SantiagoArenas2/Arqui_proyecto3/asic/resultados/corridas.csv

corrida | terminada | CLOCK_PERIOD | FP_CORE_UTIL | die_area_um2 | core_area_um2 | area_celdas_um2 | utilizacion | celdas | flip_flops_sintesis | setup_ws | setup_ws_tt | setup_ws_ss_max | setup_tns | setup_tns_tt | setup_tns_ss_max | hold_ws | hold_ws_tt | hold_ws_ss_max | hold_tns | hold_tns_tt | hold_tns_ss_max | drc_magic | drc_klayout | drc_ruteo | lvs_errores | antena_redes | antena_pines | max_slew | max_cap | largo_ruteo_um | overflow_grt | cierra_timing | cierra_todo
ff | si | 100 | 40 | 2455570 | 2385420 | 1272700 | 0.533532 | 55203 | 6575 | 14.643263016615931 | 55.23154356864992 | 14.643263016615931 | 0 | 0 | 0 | 0.18638202619926572 | 0.46882654641026583 | 1.1230909853329543 | 0 | 0 | 0 | 0 |  | 0 | 0 | 0 | 0 | 28428 | 348 | 3175246 |  | si | si
final | si | 100 | 40 | 387034 | 359712 | 183260 | 0.509462 | 8506 | 846 | 29.310478429531756 | 62.80214570589592 | 29.310478429531756 | 0 | 0 | 0 | 0.1411509837853033 | 0.3911517886970189 | 0.9766532303771683 | 0 | 0 | 0 | 0 |  | 0 | 0 | 0 | 0 | 2468 | 3 | 366000 |  | si | si
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
