SantiagoArenas2/Arqui_proyecto3/asic/resultados/ff/metrics.csv

Metric | Value
design__lint_error__count | 0
design__lint_timing_construct__count | 0
design__lint_warning__count | 16
design__inferred_latch__count | 0
design__instance__count | 124674
design__instance__area | 2.38542E+6
design__instance_unmapped__count | 0
synthesis__check_error__count | 0
design__max_slew_violation__count__corner:nom_tt_025C_5v00 | 1798
design__max_fanout_violation__count__corner:nom_tt_025C_5v00 | 465
design__max_cap_violation__count__corner:nom_tt_025C_5v00 | 216
power__internal__total | 0.06361744552850723
power__switching__total | 0.01822611875832081
power__leakage__total | 0.000013872431736672297
power__total | 0.08185743540525436
clock__skew__worst_hold__corner:nom_tt_025C_5v00 | -0.7859335626980152
clock__skew__worst_setup__corner:nom_tt_025C_5v00 | 0.5374261188189581
timing__hold__ws__corner:nom_tt_025C_5v00 | 0.46882654641026583
timing__setup__ws__corner:nom_tt_025C_5v00 | 55.23154356864992
timing__hold__tns__corner:nom_tt_025C_5v00 | 0.0
timing__setup__tns__corner:nom_tt_025C_5v00 | 0.0
timing__hold__wns__corner:nom_tt_025C_5v00 | 0
timing__setup__wns__corner:nom_tt_025C_5v00 | 0.0
timing__hold_vio__count__corner:nom_tt_025C_5v00 | 0
timing__hold_r2r__ws__corner:nom_tt_025C_5v00 | 0.468827
timing__hold_r2r_vio__count__corner:nom_tt_025C_5v00 | 0
timing__setup_vio__count__corner:nom_tt_025C_5v00 | 0
timing__setup_r2r__ws__corner:nom_tt_025C_5v00 | 55.231544
timing__setup_r2r_vio__count__corner:nom_tt_025C_5v00 | 0
design__max_slew_violation__count__corner:nom_ss_125C_4v50 | 23036
design__max_fanout_violation__count__corner:nom_ss_125C_4v50 | 465
design__max_cap_violation__count__corner:nom_ss_125C_4v50 | 223
clock__skew__worst_hold__corner:nom_ss_125C_4v50 | -1.1883809828116376
clock__skew__worst_setup__corner:nom_ss_125C_4v50 | 0.7531262493478827
timing__hold__ws__corner:nom_ss_125C_4v50 | 1.1118968283036714
timing__setup__ws__corner:nom_ss_125C_4v50 | 18.774500707711688
timing__hold__tns__corner:nom_ss_125C_4v50 | 0.0
timing__setup__tns__corner:nom_ss_125C_4v50 | 0.0
timing__hold__wns__corner:nom_ss_125C_4v50 | 0
timing__setup__wns__corner:nom_ss_125C_4v50 | 0.0
timing__hold_vio__count__corner:nom_ss_125C_4v50 | 0
timing__hold_r2r__ws__corner:nom_ss_125C_4v50 | 1.111897
timing__hold_r2r_vio__count__corner:nom_ss_125C_4v50 | 0
timing__setup_vio__count__corner:nom_ss_125C_4v50 | 0
timing__setup_r2r__ws__corner:nom_ss_125C_4v50 | 18.774500
timing__setup_r2r_vio__count__corner:nom_ss_125C_4v50 | 0
design__max_slew_violation__count__corner:nom_ff_n40C_5v50 | 451
design__max_fanout_violation__count__corner:nom_ff_n40C_5v50 | 465
design__max_cap_violation__count__corner:nom_ff_n40C_5v50 | 215
clock__skew__worst_hold__corner:nom_ff_n40C_5v50 | -0.6039897641875127
clock__skew__worst_setup__corner:nom_ff_n40C_5v50 | 0.4395209043344107
timing__hold__ws__corner:nom_ff_n40C_5v50 | 0.18947444149951612
timing__setup__ws__corner:nom_ff_n40C_5v50 | 71.54914019330538
timing__hold__tns__corner:nom_ff_n40C_5v50 | 0.0
timing__setup__tns__corner:nom_ff_n40C_5v50 | 0.0
timing__hold__wns__corner:nom_ff_n40C_5v50 | 0
timing__setup__wns__corner:nom_ff_n40C_5v50 | 0.0
timing__hold_vio__count__corner:nom_ff_n40C_5v50 | 0
timing__hold_r2r__ws__corner:nom_ff_n40C_5v50 | 0.189474
timing__hold_r2r_vio__count__corner:nom_ff_n40C_5v50 | 0
timing__setup_vio__count__corner:nom_ff_n40C_5v50 | 0
timing__setup_r2r__ws__corner:nom_ff_n40C_5v50 | 71.549141
timing__setup_r2r_vio__count__corner:nom_ff_n40C_5v50 | 0
design__max_slew_violation__count | 28428
design__max_fanout_violation__count | 465
design__max_cap_violation__count | 348
clock__skew__worst_hold | -0.5871761021378566
clock__skew__worst_setup | 0.4242812610224333
timing__hold__ws | 0.18638202619926572
timing__setup__ws | 14.643263016615931
timing__hold__tns | 0.0
timing__setup__tns | 0.0
timing__hold__wns | 0
timing__setup__wns | 0.0
timing__hold_vio__count | 0
timing__hold_r2r__ws | 0.186382
timing__hold_r2r_vio__count | 0
timing__setup_vio__count | 0
timing__setup_r2r__ws | 14.643263
timing__setup_r2r_vio__count | 0
design__die__bbox | 0.0 0.0 1558.09 1576.01
design__core__bbox | 6.72 15.68 1551.2 1560.16
design__io | 30
design__die__area | 2.45557E+6
design__core__area | 2.38542E+6
design__instance__count__stdcell | 55203
design__instance__area__stdcell | 1.2727E+6
design__instance__count__macros | 0
design__instance__area__macros | 0
design__instance__count__padcells | 0
design__instance__area__padcells | 0
design__instance__count__cover | 0
design__instance__area__cover | 0
design__instance__utilization | 0.533532
design__instance__utilization__stdcell | 0.533532
design__rows | 394
design__rows:GF018hv5v_mcu_sc7 | 394
design__sites | 1086652
design__sites:GF018hv5v_mcu_sc7 | 1086652
design__instance__count__class:tie_cell | 1
design__instance__area__class:tie_cell | 8.7808
design__instance__count__class:inverter | 336
design__instance__area__class:inverter | 2950.35
design__instance__count__class:sequential_cell | 6575
design__instance__area__class:sequential_cell | 493059
design__instance__count__class:multi_input_combinational_cell | 24515
design__instance__area__class:multi_input_combinational_cell | 458474
flow__warnings__count | 1
flow__errors__count | 0
flow__warnings__count:ODB-0220 | 1
flow__warnings__type_count | 1
flow__warnings__count:ORD-0039 | 1
design__instance__count__class:endcap_cell | 788
design__instance__area__class:endcap_cell | 3459.64
design__instance__count__class:tap_cell | 15450
design__instance__area__class:tap_cell | 67831.7
design__power_grid_violation__count__net:VSS | 0
design__power_grid_violation__count__net:VDD | 0
design__power_grid_violation__count | 0
flow__warnings__count:GRT-0281 | 10
timing__drv__floating__nets | 2
timing__drv__floating__pins | 0
design__instance__displacement__total | 47.514
design__instance__displacement__mean | 0.0005
design__instance__displacement__max | 9.949
route__wirelength__estimated | 2.65529E+6
design__violations | 0
design__instance__count__class:timing_repair_buffer | 6250
design__instance__area__class:timing_repair_buffer | 209165
flow__warnings__count:RSZ-0020 | 1
flow__warnings__count:STA-1140 | 6
design__instance__count__class:clock_buffer | 709
design__instance__area__class:clock_buffer | 33367
design__instance__count__class:clock_inverter | 192
design__instance__area__class:clock_inverter | 2682.53
design__instance__count__setup_buffer | 0
design__instance__count__hold_buffer | 5
global_route__vias | 157
global_route__wirelength | 4188357
antenna__violating__nets | 0
antenna__violating__pins | 0
route__antenna_violation__count | 0
antenna_diodes_count | 169
design__instance__count__class:antenna_cell | 387
design__instance__area__class:antenna_cell | 1699.08
flow__warnings__count:GRT-0243 | 1
route__net | 38211
route__net__special | 2
route__drc_errors__iter:0 | 146
route__wirelength__iter:0 | 3175386
route__drc_errors__iter:1 | 23
route__wirelength__iter:1 | 3175315
route__drc_errors__iter:2 | 13
route__wirelength__iter:2 | 3175297
route__drc_errors__iter:3 | 0
route__wirelength__iter:3 | 3175246
route__drc_errors__iter:4 | 0
route__wirelength__iter:4 | 3175293
route__drc_errors | 0
route__wirelength | 3175246
route__vias | 321902
route__vias__singlecut | 321902
route__vias__multicut | 0
flow__warnings__count:DRT-0349 | 8
design__disconnected_pin__count | 0
design__critical_disconnected_pin__count | 0
route__wirelength__max | 2280.36
design__instance__count__class:fill_cell | 69471
design__instance__area__class:fill_cell | 1.11272E+6
timing__unannotated_net__count__corner:nom_tt_025C_5v00 | 376
timing__unannotated_net_filtered__count__corner:nom_tt_025C_5v00 | 0
timing__unannotated_net__count__corner:nom_ss_125C_4v50 | 376
timing__unannotated_net_filtered__count__corner:nom_ss_125C_4v50 | 0
timing__unannotated_net__count__corner:nom_ff_n40C_5v50 | 376
timing__unannotated_net_filtered__count__corner:nom_ff_n40C_5v50 | 0
design__max_slew_violation__count__corner:min_tt_025C_5v00 | 1065
design__max_fanout_violation__count__corner:min_tt_025C_5v00 | 465
design__max_cap_violation__count__corner:min_tt_025C_5v00 | 136
clock__skew__worst_hold__corner:min_tt_025C_5v00 | -0.7615881474362896
clock__skew__worst_setup__corner:min_tt_025C_5v00 | 0.5133036363468821
timing__hold__ws__corner:min_tt_025C_5v00 | 0.4632900860744833
timing__setup__ws__corner:min_tt_025C_5v00 | 57.234435699710865
timing__hold__tns__corner:min_tt_025C_5v00 | 0.0
timing__setup__tns__corner:min_tt_025C_5v00 | 0.0
timing__hold__wns__corner:min_tt_025C_5v00 | 0
timing__setup__wns__corner:min_tt_025C_5v00 | 0.0
timing__hold_vio__count__corner:min_tt_025C_5v00 | 0
timing__hold_r2r__ws__corner:min_tt_025C_5v00 | 0.463290
timing__hold_r2r_vio__count__corner:min_tt_025C_5v00 | 0
timing__setup_vio__count__corner:min_tt_025C_5v00 | 0
timing__setup_r2r__ws__corner:min_tt_025C_5v00 | 57.234436
timing__setup_r2r_vio__count__corner:min_tt_025C_5v00 | 0
timing__unannotated_net__count__corner:min_tt_025C_5v00 | 376
timing__unannotated_net_filtered__count__corner:min_tt_025C_5v00 | 0
design__max_slew_violation__count__corner:min_ss_125C_4v50 | 16301
design__max_fanout_violation__count__corner:min_ss_125C_4v50 | 465
design__max_cap_violation__count__corner:min_ss_125C_4v50 | 138
clock__skew__worst_hold__corner:min_ss_125C_4v50 | -1.1473551322669788
clock__skew__worst_setup__corner:min_ss_125C_4v50 | 0.7116396562349738
timing__hold__ws__corner:min_ss_125C_4v50 | 1.1018795077137742
timing__setup__ws__corner:min_ss_125C_4v50 | 22.243498339494888
timing__hold__tns__corner:min_ss_125C_4v50 | 0.0
timing__setup__tns__corner:min_ss_125C_4v50 | 0.0
timing__hold__wns__corner:min_ss_125C_4v50 | 0
timing__setup__wns__corner:min_ss_125C_4v50 | 0.0
timing__hold_vio__count__corner:min_ss_125C_4v50 | 0
timing__hold_r2r__ws__corner:min_ss_125C_4v50 | 1.101879
timing__hold_r2r_vio__count__corner:min_ss_125C_4v50 | 0
timing__setup_vio__count__corner:min_ss_125C_4v50 | 0
timing__setup_r2r__ws__corner:min_ss_125C_4v50 | 22.243498
timing__setup_r2r_vio__count__corner:min_ss_125C_4v50 | 0
timing__unannotated_net__count__corner:min_ss_125C_4v50 | 376
timing__unannotated_net_filtered__count__corner:min_ss_125C_4v50 | 0
design__max_slew_violation__count__corner:min_ff_n40C_5v50 | 276
design__max_fanout_violation__count__corner:min_ff_n40C_5v50 | 465
design__max_cap_violation__count__corner:min_ff_n40C_5v50 | 137
clock__skew__worst_hold__corner:min_ff_n40C_5v50 | -0.5871761021378566
clock__skew__worst_setup__corner:min_ff_n40C_5v50 | 0.4242812610224333
timing__hold__ws__corner:min_ff_n40C_5v50 | 0.18638202619926572
timing__setup__ws__corner:min_ff_n40C_5v50 | 72.87908438572302
timing__hold__tns__corner:min_ff_n40C_5v50 | 0.0
timing__setup__tns__corner:min_ff_n40C_5v50 | 0.0
timing__hold__wns__corner:min_ff_n40C_5v50 | 0
timing__setup__wns__corner:min_ff_n40C_5v50 | 0.0
timing__hold_vio__count__corner:min_ff_n40C_5v50 | 0
timing__hold_r2r__ws__corner:min_ff_n40C_5v50 | 0.186382
timing__hold_r2r_vio__count__corner:min_ff_n40C_5v50 | 0
timing__setup_vio__count__corner:min_ff_n40C_5v50 | 0
timing__setup_r2r__ws__corner:min_ff_n40C_5v50 | 72.879082
timing__setup_r2r_vio__count__corner:min_ff_n40C_5v50 | 0
timing__unannotated_net__count__corner:min_ff_n40C_5v50 | 376
timing__unannotated_net_filtered__count__corner:min_ff_n40C_5v50 | 0
design__max_slew_violation__count__corner:max_tt_025C_5v00 | 2842
design__max_fanout_violation__count__corner:max_tt_025C_5v00 | 465
design__max_cap_violation__count__corner:max_tt_025C_5v00 | 342
clock__skew__worst_hold__corner:max_tt_025C_5v00 | -0.8159806394862599
clock__skew__worst_setup__corner:max_tt_025C_5v00 | 0.5679584741049909
timing__hold__ws__corner:max_tt_025C_5v00 | 0.4750604488698429
timing__setup__ws__corner:max_tt_025C_5v00 | 52.808980016984194
timing__hold__tns__corner:max_tt_025C_5v00 | 0.0
timing__setup__tns__corner:max_tt_025C_5v00 | 0.0
timing__hold__wns__corner:max_tt_025C_5v00 | 0
timing__setup__wns__corner:max_tt_025C_5v00 | 0.0
timing__hold_vio__count__corner:max_tt_025C_5v00 | 0
timing__hold_r2r__ws__corner:max_tt_025C_5v00 | 0.475060
timing__hold_r2r_vio__count__corner:max_tt_025C_5v00 | 0
timing__setup_vio__count__corner:max_tt_025C_5v00 | 0
timing__setup_r2r__ws__corner:max_tt_025C_5v00 | 52.808979
timing__setup_r2r_vio__count__corner:max_tt_025C_5v00 | 0
timing__unannotated_net__count__corner:max_tt_025C_5v00 | 376
timing__unannotated_net_filtered__count__corner:max_tt_025C_5v00 | 0
design__max_slew_violation__count__corner:max_ss_125C_4v50 | 28428
design__max_fanout_violation__count__corner:max_ss_125C_4v50 | 465
design__max_cap_violation__count__corner:max_ss_125C_4v50 | 348
clock__skew__worst_hold__corner:max_ss_125C_4v50 | -1.2388419529756143
clock__skew__worst_setup__corner:max_ss_125C_4v50 | 0.8052694294863475
timing__hold__ws__corner:max_ss_125C_4v50 | 1.1230909853329543
timing__setup__ws__corner:max_ss_125C_4v50 | 14.643263016615931
timing__hold__tns__corner:max_ss_125C_4v50 | 0.0
timing__setup__tns__corner:max_ss_125C_4v50 | 0.0
timing__hold__wns__corner:max_ss_125C_4v50 | 0
timing__setup__wns__corner:max_ss_125C_4v50 | 0.0
timing__hold_vio__count__corner:max_ss_125C_4v50 | 0
timing__hold_r2r__ws__corner:max_ss_125C_4v50 | 1.123091
timing__hold_r2r_vio__count__corner:max_ss_125C_4v50 | 0
timing__setup_vio__count__corner:max_ss_125C_4v50 | 0
timing__setup_r2r__ws__corner:max_ss_125C_4v50 | 14.643263
timing__setup_r2r_vio__count__corner:max_ss_125C_4v50 | 0
timing__unannotated_net__count__corner:max_ss_125C_4v50 | 376
timing__unannotated_net_filtered__count__corner:max_ss_125C_4v50 | 0
design__max_slew_violation__count__corner:max_ff_n40C_5v50 | 812
design__max_fanout_violation__count__corner:max_ff_n40C_5v50 | 465
design__max_cap_violation__count__corner:max_ff_n40C_5v50 | 335
clock__skew__worst_hold__corner:max_ff_n40C_5v50 | -0.6248592931054371
clock__skew__worst_setup__corner:max_ff_n40C_5v50 | 0.46017616020252244
timing__hold__ws__corner:max_ff_n40C_5v50 | 0.1933033787751331
timing__setup__ws__corner:max_ff_n40C_5v50 | 69.9178477127018
timing__hold__tns__corner:max_ff_n40C_5v50 | 0.0
timing__setup__tns__corner:max_ff_n40C_5v50 | 0.0
timing__hold__wns__corner:max_ff_n40C_5v50 | 0
timing__setup__wns__corner:max_ff_n40C_5v50 | 0.0
timing__hold_vio__count__corner:max_ff_n40C_5v50 | 0
timing__hold_r2r__ws__corner:max_ff_n40C_5v50 | 0.193303
timing__hold_r2r_vio__count__corner:max_ff_n40C_5v50 | 0
timing__setup_vio__count__corner:max_ff_n40C_5v50 | 0
timing__setup_r2r__ws__corner:max_ff_n40C_5v50 | 69.917847
timing__setup_r2r_vio__count__corner:max_ff_n40C_5v50 | 0
timing__unannotated_net__count__corner:max_ff_n40C_5v50 | 376
timing__unannotated_net_filtered__count__corner:max_ff_n40C_5v50 | 0
timing__unannotated_net__count | 376
timing__unannotated_net_filtered__count | 0
design_powergrid__voltage__worst__net:VDD__corner:nom_tt_025C_5v00 | 4.99985
design_powergrid__drop__average__net:VDD__corner:nom_tt_025C_5v00 | 4.99997
design_powergrid__drop__worst__net:VDD__corner:nom_tt_025C_5v00 | 0.000148198
design_powergrid__voltage__worst__net:VSS__corner:nom_tt_025C_5v00 | 0.000153351
design_powergrid__drop__average__net:VSS__corner:nom_tt_025C_5v00 | 0.0000316553
design_powergrid__drop__worst__net:VSS__corner:nom_tt_025C_5v00 | 0.000153351
design_powergrid__voltage__worst | 0.000153351
design_powergrid__voltage__worst__net:VDD | 4.99985
design_powergrid__drop__worst | 0.000153351
design_powergrid__drop__worst__net:VDD | 0.000148198
design_powergrid__voltage__worst__net:VSS | 0.000153351
design_powergrid__drop__worst__net:VSS | 0.000153351
ir__voltage__worst | 5
ir__drop__avg | 0.0000324999999999999971528850950530653562964289449155330657958984375
ir__drop__worst | 0.00014799999999999999245568760297686594640254043042659759521484375
design__xor_difference__count | 0
magic__drc_error__count | 0
magic__illegal_overlap__count | 0
design__lvs_device_difference__count | 0
design__lvs_net_difference__count | 0
design__lvs_property_fail__count | 0
design__lvs_error__count | 0
design__lvs_unmatched_device__count | 0
design__lvs_unmatched_net__count | 0
design__lvs_unmatched_pin__count | 0
