SantiagoArenas2/Arqui_proyecto3/asic/resultados/final/metrics.csv

Metric | Value
design__lint_error__count | 0
design__lint_timing_construct__count | 0
design__lint_warning__count | 13
design__inferred_latch__count | 0
design__instance__count | 20113
design__instance__area | 359712
design__instance_unmapped__count | 0
synthesis__check_error__count | 0
design__max_slew_violation__count__corner:nom_tt_025C_5v00 | 11
design__max_fanout_violation__count__corner:nom_tt_025C_5v00 | 56
design__max_cap_violation__count__corner:nom_tt_025C_5v00 | 2
power__internal__total | 0.025040501728653908
power__switching__total | 0.019503958523273468
power__leakage__total | 0.000002168780611100374
power__total | 0.04454662650823593
clock__skew__worst_hold__corner:nom_tt_025C_5v00 | -0.5358046380456344
clock__skew__worst_setup__corner:nom_tt_025C_5v00 | 0.39693990884402575
timing__hold__ws__corner:nom_tt_025C_5v00 | 0.3911517886970189
timing__setup__ws__corner:nom_tt_025C_5v00 | 62.80214570589592
timing__hold__tns__corner:nom_tt_025C_5v00 | 0.0
timing__setup__tns__corner:nom_tt_025C_5v00 | 0.0
timing__hold__wns__corner:nom_tt_025C_5v00 | 0
timing__setup__wns__corner:nom_tt_025C_5v00 | 0.0
timing__hold_vio__count__corner:nom_tt_025C_5v00 | 0
timing__hold_r2r__ws__corner:nom_tt_025C_5v00 | 0.391152
timing__hold_r2r_vio__count__corner:nom_tt_025C_5v00 | 0
timing__setup_vio__count__corner:nom_tt_025C_5v00 | 0
timing__setup_r2r__ws__corner:nom_tt_025C_5v00 | 62.802147
timing__setup_r2r_vio__count__corner:nom_tt_025C_5v00 | 0
design__max_slew_violation__count__corner:nom_ss_125C_4v50 | 1823
design__max_fanout_violation__count__corner:nom_ss_125C_4v50 | 56
design__max_cap_violation__count__corner:nom_ss_125C_4v50 | 2
clock__skew__worst_hold__corner:nom_ss_125C_4v50 | -0.7544636240411697
clock__skew__worst_setup__corner:nom_ss_125C_4v50 | 0.5092379995157207
timing__hold__ws__corner:nom_ss_125C_4v50 | 0.9646566041229909
timing__setup__ws__corner:nom_ss_125C_4v50 | 31.980783371167885
timing__hold__tns__corner:nom_ss_125C_4v50 | 0.0
timing__setup__tns__corner:nom_ss_125C_4v50 | 0.0
timing__hold__wns__corner:nom_ss_125C_4v50 | 0
timing__setup__wns__corner:nom_ss_125C_4v50 | 0.0
timing__hold_vio__count__corner:nom_ss_125C_4v50 | 0
timing__hold_r2r__ws__corner:nom_ss_125C_4v50 | 0.964657
timing__hold_r2r_vio__count__corner:nom_ss_125C_4v50 | 0
timing__setup_vio__count__corner:nom_ss_125C_4v50 | 0
timing__setup_r2r__ws__corner:nom_ss_125C_4v50 | 31.980783
timing__setup_r2r_vio__count__corner:nom_ss_125C_4v50 | 0
design__max_slew_violation__count__corner:nom_ff_n40C_5v50 | 0
design__max_fanout_violation__count__corner:nom_ff_n40C_5v50 | 56
design__max_cap_violation__count__corner:nom_ff_n40C_5v50 | 2
clock__skew__worst_hold__corner:nom_ff_n40C_5v50 | -0.4371146068827834
clock__skew__worst_setup__corner:nom_ff_n40C_5v50 | 0.34640935545001283
timing__hold__ws__corner:nom_ff_n40C_5v50 | 0.14545121074820264
timing__setup__ws__corner:nom_ff_n40C_5v50 | 75.54064965146212
timing__hold__tns__corner:nom_ff_n40C_5v50 | 0.0
timing__setup__tns__corner:nom_ff_n40C_5v50 | 0.0
timing__hold__wns__corner:nom_ff_n40C_5v50 | 0
timing__setup__wns__corner:nom_ff_n40C_5v50 | 0.0
timing__hold_vio__count__corner:nom_ff_n40C_5v50 | 0
timing__hold_r2r__ws__corner:nom_ff_n40C_5v50 | 0.145451
timing__hold_r2r_vio__count__corner:nom_ff_n40C_5v50 | 0
timing__setup_vio__count__corner:nom_ff_n40C_5v50 | 0
timing__setup_r2r__ws__corner:nom_ff_n40C_5v50 | 76.505951
timing__setup_r2r_vio__count__corner:nom_ff_n40C_5v50 | 0
design__max_slew_violation__count | 2468
design__max_fanout_violation__count | 56
design__max_cap_violation__count | 3
clock__skew__worst_hold | -0.4312405277156639
clock__skew__worst_setup | 0.3399583211162538
timing__hold__ws | 0.1411509837853033
timing__setup__ws | 29.310478429531756
timing__hold__tns | 0.0
timing__setup__tns | 0.0
timing__hold__wns | 0
timing__setup__wns | 0.0
timing__hold_vio__count | 0
timing__hold_r2r__ws | 0.141151
timing__hold_r2r_vio__count | 0
timing__setup_vio__count | 0
timing__setup_r2r__ws | 29.310478
timing__setup_r2r_vio__count | 0
design__die__bbox | 0.0 0.0 613.225 631.145
design__core__bbox | 6.72 15.68 606.48 615.44
design__io | 30
design__die__area | 387034
design__core__area | 359712
design__instance__count__stdcell | 8506
design__instance__area__stdcell | 183260
design__instance__count__macros | 0
design__instance__area__macros | 0
design__instance__count__padcells | 0
design__instance__area__padcells | 0
design__instance__count__cover | 0
design__instance__area__cover | 0
design__instance__utilization | 0.509462
design__instance__utilization__stdcell | 0.509462
design__rows | 153
design__rows:GF018hv5v_mcu_sc7 | 153
design__sites | 163863
design__sites:GF018hv5v_mcu_sc7 | 163863
design__instance__count__class:tie_cell | 1
design__instance__area__class:tie_cell | 8.7808
design__instance__count__class:inverter | 325
design__instance__area__class:inverter | 2853.76
design__instance__count__class:sequential_cell | 846
design__instance__area__class:sequential_cell | 57536.2
design__instance__count__class:multi_input_combinational_cell | 3901
design__instance__area__class:multi_input_combinational_cell | 83525.2
flow__warnings__count | 1
flow__errors__count | 0
flow__warnings__count:ODB-0220 | 1
flow__warnings__type_count | 1
flow__warnings__count:ORD-0039 | 1
design__instance__count__class:endcap_cell | 306
design__instance__area__class:endcap_cell | 1343.46
design__instance__count__class:tap_cell | 2327
design__instance__area__class:tap_cell | 10216.5
design__power_grid_violation__count__net:VSS | 0
design__power_grid_violation__count__net:VDD | 0
design__power_grid_violation__count | 0
timing__drv__floating__nets | 2
timing__drv__floating__pins | 0
design__instance__displacement__total | 98.406
design__instance__displacement__mean | 0.0115
design__instance__displacement__max | 9.091
route__wirelength__estimated | 311118
design__violations | 0
design__instance__count__class:timing_repair_buffer | 681
design__instance__area__class:timing_repair_buffer | 22617.1
flow__warnings__count:RSZ-0020 | 1
flow__warnings__count:STA-1140 | 6
design__instance__count__class:clock_buffer | 80
design__instance__area__class:clock_buffer | 4618.7
design__instance__count__class:clock_inverter | 33
design__instance__area__class:clock_inverter | 513.677
design__instance__count__setup_buffer | 0
design__instance__count__hold_buffer | 7
global_route__vias | 66
global_route__wirelength | 502294
antenna__violating__nets | 0
antenna__violating__pins | 0
route__antenna_violation__count | 0
antenna_diodes_count | 4
design__instance__count__class:antenna_cell | 6
design__instance__area__class:antenna_cell | 26.3424
route__net | 5828
route__net__special | 2
route__drc_errors__iter:0 | 65
route__wirelength__iter:0 | 366071
route__drc_errors__iter:1 | 8
route__wirelength__iter:1 | 366051
route__drc_errors__iter:2 | 7
route__wirelength__iter:2 | 366051
route__drc_errors__iter:3 | 0
route__wirelength__iter:3 | 366000
route__drc_errors__iter:4 | 0
route__wirelength__iter:4 | 366022
route__drc_errors | 0
route__wirelength | 366000
route__vias | 43618
route__vias__singlecut | 43618
route__vias__multicut | 0
flow__warnings__count:DRT-0349 | 8
design__disconnected_pin__count | 0
design__critical_disconnected_pin__count | 0
route__wirelength__max | 1136.74
design__instance__count__class:fill_cell | 11607
design__instance__area__class:fill_cell | 176452
timing__unannotated_net__count__corner:nom_tt_025C_5v00 | 48
timing__unannotated_net_filtered__count__corner:nom_tt_025C_5v00 | 0
timing__unannotated_net__count__corner:nom_ss_125C_4v50 | 48
timing__unannotated_net_filtered__count__corner:nom_ss_125C_4v50 | 0
timing__unannotated_net__count__corner:nom_ff_n40C_5v50 | 48
timing__unannotated_net_filtered__count__corner:nom_ff_n40C_5v50 | 0
design__max_slew_violation__count__corner:min_tt_025C_5v00 | 0
design__max_fanout_violation__count__corner:min_tt_025C_5v00 | 56
design__max_cap_violation__count__corner:min_tt_025C_5v00 | 1
clock__skew__worst_hold__corner:min_tt_025C_5v00 | -0.5270964924834013
clock__skew__worst_setup__corner:min_tt_025C_5v00 | 0.38714768597873767
timing__hold__ws__corner:min_tt_025C_5v00 | 0.38482373932229097
timing__setup__ws__corner:min_tt_025C_5v00 | 64.07531042669314
timing__hold__tns__corner:min_tt_025C_5v00 | 0.0
timing__setup__tns__corner:min_tt_025C_5v00 | 0.0
timing__hold__wns__corner:min_tt_025C_5v00 | 0
timing__setup__wns__corner:min_tt_025C_5v00 | 0.0
timing__hold_vio__count__corner:min_tt_025C_5v00 | 0
timing__hold_r2r__ws__corner:min_tt_025C_5v00 | 0.384824
timing__hold_r2r_vio__count__corner:min_tt_025C_5v00 | 0
timing__setup_vio__count__corner:min_tt_025C_5v00 | 0
timing__setup_r2r__ws__corner:min_tt_025C_5v00 | 64.075310
timing__setup_r2r_vio__count__corner:min_tt_025C_5v00 | 0
timing__unannotated_net__count__corner:min_tt_025C_5v00 | 48
timing__unannotated_net_filtered__count__corner:min_tt_025C_5v00 | 0
design__max_slew_violation__count__corner:min_ss_125C_4v50 | 1400
design__max_fanout_violation__count__corner:min_ss_125C_4v50 | 56
design__max_cap_violation__count__corner:min_ss_125C_4v50 | 1
clock__skew__worst_hold__corner:min_ss_125C_4v50 | -0.7395857469119979
clock__skew__worst_setup__corner:min_ss_125C_4v50 | 0.4902132172276864
timing__hold__ws__corner:min_ss_125C_4v50 | 0.953570804863976
timing__setup__ws__corner:min_ss_125C_4v50 | 34.12412138335125
timing__hold__tns__corner:min_ss_125C_4v50 | 0.0
timing__setup__tns__corner:min_ss_125C_4v50 | 0.0
timing__hold__wns__corner:min_ss_125C_4v50 | 0
timing__setup__wns__corner:min_ss_125C_4v50 | 0.0
timing__hold_vio__count__corner:min_ss_125C_4v50 | 0
timing__hold_r2r__ws__corner:min_ss_125C_4v50 | 0.953571
timing__hold_r2r_vio__count__corner:min_ss_125C_4v50 | 0
timing__setup_vio__count__corner:min_ss_125C_4v50 | 0
timing__setup_r2r__ws__corner:min_ss_125C_4v50 | 34.124123
timing__setup_r2r_vio__count__corner:min_ss_125C_4v50 | 0
timing__unannotated_net__count__corner:min_ss_125C_4v50 | 48
timing__unannotated_net_filtered__count__corner:min_ss_125C_4v50 | 0
design__max_slew_violation__count__corner:min_ff_n40C_5v50 | 0
design__max_fanout_violation__count__corner:min_ff_n40C_5v50 | 56
design__max_cap_violation__count__corner:min_ff_n40C_5v50 | 1
clock__skew__worst_hold__corner:min_ff_n40C_5v50 | -0.4312405277156639
clock__skew__worst_setup__corner:min_ff_n40C_5v50 | 0.3399583211162538
timing__hold__ws__corner:min_ff_n40C_5v50 | 0.1411509837853033
timing__setup__ws__corner:min_ff_n40C_5v50 | 75.61333106995859
timing__hold__tns__corner:min_ff_n40C_5v50 | 0.0
timing__setup__tns__corner:min_ff_n40C_5v50 | 0.0
timing__hold__wns__corner:min_ff_n40C_5v50 | 0
timing__setup__wns__corner:min_ff_n40C_5v50 | 0.0
timing__hold_vio__count__corner:min_ff_n40C_5v50 | 0
timing__hold_r2r__ws__corner:min_ff_n40C_5v50 | 0.141151
timing__hold_r2r_vio__count__corner:min_ff_n40C_5v50 | 0
timing__setup_vio__count__corner:min_ff_n40C_5v50 | 0
timing__setup_r2r__ws__corner:min_ff_n40C_5v50 | 77.353607
timing__setup_r2r_vio__count__corner:min_ff_n40C_5v50 | 0
timing__unannotated_net__count__corner:min_ff_n40C_5v50 | 48
timing__unannotated_net_filtered__count__corner:min_ff_n40C_5v50 | 0
design__max_slew_violation__count__corner:max_tt_025C_5v00 | 43
design__max_fanout_violation__count__corner:max_tt_025C_5v00 | 56
design__max_cap_violation__count__corner:max_tt_025C_5v00 | 3
clock__skew__worst_hold__corner:max_tt_025C_5v00 | -0.5465300589006638
clock__skew__worst_setup__corner:max_tt_025C_5v00 | 0.4085955300865452
timing__hold__ws__corner:max_tt_025C_5v00 | 0.39808535372650256
timing__setup__ws__corner:max_tt_025C_5v00 | 61.2619163848828
timing__hold__tns__corner:max_tt_025C_5v00 | 0.0
timing__setup__tns__corner:max_tt_025C_5v00 | 0.0
timing__hold__wns__corner:max_tt_025C_5v00 | 0
timing__setup__wns__corner:max_tt_025C_5v00 | 0.0
timing__hold_vio__count__corner:max_tt_025C_5v00 | 0
timing__hold_r2r__ws__corner:max_tt_025C_5v00 | 0.398085
timing__hold_r2r_vio__count__corner:max_tt_025C_5v00 | 0
timing__setup_vio__count__corner:max_tt_025C_5v00 | 0
timing__setup_r2r__ws__corner:max_tt_025C_5v00 | 61.261917
timing__setup_r2r_vio__count__corner:max_tt_025C_5v00 | 0
timing__unannotated_net__count__corner:max_tt_025C_5v00 | 48
timing__unannotated_net_filtered__count__corner:max_tt_025C_5v00 | 0
design__max_slew_violation__count__corner:max_ss_125C_4v50 | 2468
design__max_fanout_violation__count__corner:max_ss_125C_4v50 | 56
design__max_cap_violation__count__corner:max_ss_125C_4v50 | 3
clock__skew__worst_hold__corner:max_ss_125C_4v50 | -0.7728151670680308
clock__skew__worst_setup__corner:max_ss_125C_4v50 | 0.534161840989635
timing__hold__ws__corner:max_ss_125C_4v50 | 0.9766532303771683
timing__setup__ws__corner:max_ss_125C_4v50 | 29.310478429531756
timing__hold__tns__corner:max_ss_125C_4v50 | 0.0
timing__setup__tns__corner:max_ss_125C_4v50 | 0.0
timing__hold__wns__corner:max_ss_125C_4v50 | 0
timing__setup__wns__corner:max_ss_125C_4v50 | 0.0
timing__hold_vio__count__corner:max_ss_125C_4v50 | 0
timing__hold_r2r__ws__corner:max_ss_125C_4v50 | 0.976653
timing__hold_r2r_vio__count__corner:max_ss_125C_4v50 | 0
timing__setup_vio__count__corner:max_ss_125C_4v50 | 0
timing__setup_r2r__ws__corner:max_ss_125C_4v50 | 29.310478
timing__setup_r2r_vio__count__corner:max_ss_125C_4v50 | 0
timing__unannotated_net__count__corner:max_ss_125C_4v50 | 48
timing__unannotated_net_filtered__count__corner:max_ss_125C_4v50 | 0
design__max_slew_violation__count__corner:max_ff_n40C_5v50 | 0
design__max_fanout_violation__count__corner:max_ff_n40C_5v50 | 56
design__max_cap_violation__count__corner:max_ff_n40C_5v50 | 3
clock__skew__worst_hold__corner:max_ff_n40C_5v50 | -0.4443120164215313
clock__skew__worst_setup__corner:max_ff_n40C_5v50 | 0.3542612969914398
timing__hold__ws__corner:max_ff_n40C_5v50 | 0.15034363068918538
timing__setup__ws__corner:max_ff_n40C_5v50 | 75.45366500729028
timing__hold__tns__corner:max_ff_n40C_5v50 | 0.0
timing__setup__tns__corner:max_ff_n40C_5v50 | 0.0
timing__hold__wns__corner:max_ff_n40C_5v50 | 0
timing__setup__wns__corner:max_ff_n40C_5v50 | 0.0
timing__hold_vio__count__corner:max_ff_n40C_5v50 | 0
timing__hold_r2r__ws__corner:max_ff_n40C_5v50 | 0.150344
timing__hold_r2r_vio__count__corner:max_ff_n40C_5v50 | 0
timing__setup_vio__count__corner:max_ff_n40C_5v50 | 0
timing__setup_r2r__ws__corner:max_ff_n40C_5v50 | 75.488525
timing__setup_r2r_vio__count__corner:max_ff_n40C_5v50 | 0
timing__unannotated_net__count__corner:max_ff_n40C_5v50 | 48
timing__unannotated_net_filtered__count__corner:max_ff_n40C_5v50 | 0
timing__unannotated_net__count | 48
timing__unannotated_net_filtered__count | 0
design_powergrid__voltage__worst__net:VDD__corner:nom_tt_025C_5v00 | 4.99939
design_powergrid__drop__average__net:VDD__corner:nom_tt_025C_5v00 | 4.99988
design_powergrid__drop__worst__net:VDD__corner:nom_tt_025C_5v00 | 0.000614403
design_powergrid__voltage__worst__net:VSS__corner:nom_tt_025C_5v00 | 0.000582457
design_powergrid__drop__average__net:VSS__corner:nom_tt_025C_5v00 | 0.000117475
design_powergrid__drop__worst__net:VSS__corner:nom_tt_025C_5v00 | 0.000582457
design_powergrid__voltage__worst | 0.000582457
design_powergrid__voltage__worst__net:VDD | 4.99939
design_powergrid__drop__worst | 0.000614403
design_powergrid__drop__worst__net:VDD | 0.000614403
design_powergrid__voltage__worst__net:VSS | 0.000582457
design_powergrid__drop__worst__net:VSS | 0.000582457
ir__voltage__worst | 5
ir__drop__avg | 0.000120000000000000003040102891649354432956897653639316558837890625
ir__drop__worst | 0.0006139999999999999624744617676697089336812496185302734375
design__xor_difference__count | 0
magic__drc_error__count | 0
magic__illegal_overlap__count | 0
design__lvs_device_difference__count | 0
design__lvs_net_difference__count | 0
design__lvs_property_fail__count | 0
design__lvs_error__count | 0
design__lvs_unmatched_device__count | 0
design__lvs_unmatched_net__count | 0
design__lvs_unmatched_pin__count | 0
