SantiagoArenas2/Arqui_proyecto3/asic/resultados/periodo_20/metrics.csv

Metric | Value
design__lint_error__count | 0
design__lint_timing_construct__count | 0
design__lint_warning__count | 13
design__inferred_latch__count | 0
design__instance__count | 20029
design__instance__area | 359712
design__instance_unmapped__count | 0
synthesis__check_error__count | 0
design__max_slew_violation__count__corner:nom_tt_025C_5v00 | 0
design__max_fanout_violation__count__corner:nom_tt_025C_5v00 | 55
design__max_cap_violation__count__corner:nom_tt_025C_5v00 | 3
power__internal__total | 0.13213317096233368
power__switching__total | 0.10274060070514679
power__leakage__total | 0.0000022047820493753534
power__total | 0.23487597703933716
clock__skew__worst_hold__corner:nom_tt_025C_5v00 | -0.5327247682659171
clock__skew__worst_setup__corner:nom_tt_025C_5v00 | 0.388864201845657
timing__hold__ws__corner:nom_tt_025C_5v00 | 0.3911518997193245
timing__setup__ws__corner:nom_tt_025C_5v00 | 2.7956571182672882
timing__hold__tns__corner:nom_tt_025C_5v00 | 0.0
timing__setup__tns__corner:nom_tt_025C_5v00 | 0.0
timing__hold__wns__corner:nom_tt_025C_5v00 | 0
timing__setup__wns__corner:nom_tt_025C_5v00 | 0.0
timing__hold_vio__count__corner:nom_tt_025C_5v00 | 0
timing__hold_r2r__ws__corner:nom_tt_025C_5v00 | 0.391152
timing__hold_r2r_vio__count__corner:nom_tt_025C_5v00 | 0
timing__setup_vio__count__corner:nom_tt_025C_5v00 | 0
timing__setup_r2r__ws__corner:nom_tt_025C_5v00 | 2.795657
timing__setup_r2r_vio__count__corner:nom_tt_025C_5v00 | 0
design__max_slew_violation__count__corner:nom_ss_125C_4v50 | 1678
design__max_fanout_violation__count__corner:nom_ss_125C_4v50 | 55
design__max_cap_violation__count__corner:nom_ss_125C_4v50 | 3
clock__skew__worst_hold__corner:nom_ss_125C_4v50 | -0.7491967258633899
clock__skew__worst_setup__corner:nom_ss_125C_4v50 | 0.4994494958976703
timing__hold__ws__corner:nom_ss_125C_4v50 | 0.9646592686583254
timing__setup__ws__corner:nom_ss_125C_4v50 | -10.80472986108112
timing__hold__tns__corner:nom_ss_125C_4v50 | 0.0
timing__setup__tns__corner:nom_ss_125C_4v50 | -5635.790489807097
timing__hold__wns__corner:nom_ss_125C_4v50 | 0
timing__setup__wns__corner:nom_ss_125C_4v50 | -10.80472986108112
timing__hold_vio__count__corner:nom_ss_125C_4v50 | 0
timing__hold_r2r__ws__corner:nom_ss_125C_4v50 | 0.964659
timing__hold_r2r_vio__count__corner:nom_ss_125C_4v50 | 0
timing__setup_vio__count__corner:nom_ss_125C_4v50 | 769
timing__setup_r2r__ws__corner:nom_ss_125C_4v50 | -10.804729
timing__setup_r2r_vio__count__corner:nom_ss_125C_4v50 | 769
design__max_slew_violation__count__corner:nom_ff_n40C_5v50 | 0
design__max_fanout_violation__count__corner:nom_ff_n40C_5v50 | 55
design__max_cap_violation__count__corner:nom_ff_n40C_5v50 | 3
clock__skew__worst_hold__corner:nom_ff_n40C_5v50 | -0.4350531447123573
clock__skew__worst_setup__corner:nom_ff_n40C_5v50 | 0.34102938105397695
timing__hold__ws__corner:nom_ff_n40C_5v50 | 0.14545010052514662
timing__setup__ws__corner:nom_ff_n40C_5v50 | 8.900533895165411
timing__hold__tns__corner:nom_ff_n40C_5v50 | 0.0
timing__setup__tns__corner:nom_ff_n40C_5v50 | 0.0
timing__hold__wns__corner:nom_ff_n40C_5v50 | 0
timing__setup__wns__corner:nom_ff_n40C_5v50 | 0.0
timing__hold_vio__count__corner:nom_ff_n40C_5v50 | 0
timing__hold_r2r__ws__corner:nom_ff_n40C_5v50 | 0.145450
timing__hold_r2r_vio__count__corner:nom_ff_n40C_5v50 | 0
timing__setup_vio__count__corner:nom_ff_n40C_5v50 | 0
timing__setup_r2r__ws__corner:nom_ff_n40C_5v50 | 8.900534
timing__setup_r2r_vio__count__corner:nom_ff_n40C_5v50 | 0
design__max_slew_violation__count | 2125
design__max_fanout_violation__count | 55
design__max_cap_violation__count | 3
clock__skew__worst_hold | -0.42942897675514885
clock__skew__worst_setup | 0.33524403646461015
timing__hold__ws | 0.14114987356224726
timing__setup__ws | -12.460120399249533
timing__hold__tns | 0.0
timing__setup__tns | -6475.345527505277
timing__hold__wns | 0
timing__setup__wns | -12.460120399249533
timing__hold_vio__count | 0
timing__hold_r2r__ws | 0.141150
timing__hold_r2r_vio__count | 0
timing__setup_vio__count | 2302
timing__setup_r2r__ws | -12.460120
timing__setup_r2r_vio__count | 2302
design__die__bbox | 0.0 0.0 613.225 631.145
design__core__bbox | 6.72 15.68 606.48 615.44
design__io | 30
design__die__area | 387034
design__core__area | 359712
design__instance__count__stdcell | 8515
design__instance__area__stdcell | 187510
design__instance__count__macros | 0
design__instance__area__macros | 0
design__instance__count__padcells | 0
design__instance__area__padcells | 0
design__instance__count__cover | 0
design__instance__area__cover | 0
design__instance__utilization | 0.521277
design__instance__utilization__stdcell | 0.521277
design__rows | 153
design__rows:GF018hv5v_mcu_sc7 | 153
design__sites | 163863
design__sites:GF018hv5v_mcu_sc7 | 163863
design__instance__count__class:tie_cell | 1
design__instance__area__class:tie_cell | 8.7808
design__instance__count__class:inverter | 325
design__instance__area__class:inverter | 2937.18
design__instance__count__class:sequential_cell | 846
design__instance__area__class:sequential_cell | 57562.5
design__instance__count__class:multi_input_combinational_cell | 3901
design__instance__area__class:multi_input_combinational_cell | 88247
flow__warnings__count | 1
flow__errors__count | 0
flow__warnings__count:ODB-0220 | 1
flow__warnings__type_count | 1
flow__warnings__count:ORD-0039 | 1
design__instance__count__class:endcap_cell | 306
design__instance__area__class:endcap_cell | 1343.46
design__instance__count__class:tap_cell | 2327
design__instance__area__class:tap_cell | 10216.5
design__power_grid_violation__count__net:VSS | 0
design__power_grid_violation__count__net:VDD | 0
design__power_grid_violation__count | 0
timing__drv__floating__nets | 2
timing__drv__floating__pins | 0
design__instance__displacement__total | 1897.59
design__instance__displacement__mean | 0.2225
design__instance__displacement__max | 14.56
route__wirelength__estimated | 313806
design__violations | 0
design__instance__count__class:timing_repair_buffer | 691
design__instance__area__class:timing_repair_buffer | 22039.8
flow__warnings__count:RSZ-0020 | 1
flow__warnings__count:STA-1140 | 6
design__instance__count__class:clock_buffer | 80
design__instance__area__class:clock_buffer | 4618.7
design__instance__count__class:clock_inverter | 33
design__instance__area__class:clock_inverter | 513.677
design__instance__count__setup_buffer | 11
design__instance__count__hold_buffer | 7
flow__warnings__count:RSZ-0062 | 1
global_route__vias | 54
global_route__wirelength | 507838
antenna__violating__nets | 0
antenna__violating__pins | 0
route__antenna_violation__count | 0
antenna_diodes_count | 3
design__instance__count__class:antenna_cell | 5
design__instance__area__class:antenna_cell | 21.952
route__net | 5838
route__net__special | 2
route__drc_errors__iter:0 | 35
route__wirelength__iter:0 | 368231
route__drc_errors__iter:1 | 11
route__wirelength__iter:1 | 368211
route__drc_errors__iter:2 | 9
route__wirelength__iter:2 | 368209
route__drc_errors__iter:3 | 0
route__wirelength__iter:3 | 368182
route__drc_errors__iter:4 | 0
route__wirelength__iter:4 | 368211
route__drc_errors | 0
route__wirelength | 368182
route__vias | 43755
route__vias__singlecut | 43755
route__vias__multicut | 0
flow__warnings__count:DRT-0349 | 8
design__disconnected_pin__count | 0
design__critical_disconnected_pin__count | 0
route__wirelength__max | 1138.93
design__instance__count__class:fill_cell | 11514
design__instance__area__class:fill_cell | 172202
timing__unannotated_net__count__corner:nom_tt_025C_5v00 | 48
timing__unannotated_net_filtered__count__corner:nom_tt_025C_5v00 | 0
timing__unannotated_net__count__corner:nom_ss_125C_4v50 | 48
timing__unannotated_net_filtered__count__corner:nom_ss_125C_4v50 | 0
timing__unannotated_net__count__corner:nom_ff_n40C_5v50 | 48
timing__unannotated_net_filtered__count__corner:nom_ff_n40C_5v50 | 0
design__max_slew_violation__count__corner:min_tt_025C_5v00 | 0
design__max_fanout_violation__count__corner:min_tt_025C_5v00 | 55
design__max_cap_violation__count__corner:min_tt_025C_5v00 | 1
clock__skew__worst_hold__corner:min_tt_025C_5v00 | -0.5243922111635371
clock__skew__worst_setup__corner:min_tt_025C_5v00 | 0.38016915691548503
timing__hold__ws__corner:min_tt_025C_5v00 | 0.3848240723892078
timing__setup__ws__corner:min_tt_025C_5v00 | 3.5985420106739063
timing__hold__tns__corner:min_tt_025C_5v00 | 0.0
timing__setup__tns__corner:min_tt_025C_5v00 | 0.0
timing__hold__wns__corner:min_tt_025C_5v00 | 0
timing__setup__wns__corner:min_tt_025C_5v00 | 0.0
timing__hold_vio__count__corner:min_tt_025C_5v00 | 0
timing__hold_r2r__ws__corner:min_tt_025C_5v00 | 0.384824
timing__hold_r2r_vio__count__corner:min_tt_025C_5v00 | 0
timing__setup_vio__count__corner:min_tt_025C_5v00 | 0
timing__setup_r2r__ws__corner:min_tt_025C_5v00 | 3.598542
timing__setup_r2r_vio__count__corner:min_tt_025C_5v00 | 0
timing__unannotated_net__count__corner:min_tt_025C_5v00 | 48
timing__unannotated_net_filtered__count__corner:min_tt_025C_5v00 | 0
design__max_slew_violation__count__corner:min_ss_125C_4v50 | 1269
design__max_fanout_violation__count__corner:min_ss_125C_4v50 | 55
design__max_cap_violation__count__corner:min_ss_125C_4v50 | 1
clock__skew__worst_hold__corner:min_ss_125C_4v50 | -0.7349552285899312
clock__skew__worst_setup__corner:min_ss_125C_4v50 | 0.4837083093201338
timing__hold__ws__corner:min_ss_125C_4v50 | 0.9535732473546993
timing__setup__ws__corner:min_ss_125C_4v50 | -9.405513079038222
timing__hold__tns__corner:min_ss_125C_4v50 | 0.0
timing__setup__tns__corner:min_ss_125C_4v50 | -4940.497232047388
timing__hold__wns__corner:min_ss_125C_4v50 | 0
timing__setup__wns__corner:min_ss_125C_4v50 | -9.405513079038222
timing__hold_vio__count__corner:min_ss_125C_4v50 | 0
timing__hold_r2r__ws__corner:min_ss_125C_4v50 | 0.953573
timing__hold_r2r_vio__count__corner:min_ss_125C_4v50 | 0
timing__setup_vio__count__corner:min_ss_125C_4v50 | 761
timing__setup_r2r__ws__corner:min_ss_125C_4v50 | -9.405513
timing__setup_r2r_vio__count__corner:min_ss_125C_4v50 | 761
timing__unannotated_net__count__corner:min_ss_125C_4v50 | 48
timing__unannotated_net_filtered__count__corner:min_ss_125C_4v50 | 0
design__max_slew_violation__count__corner:min_ff_n40C_5v50 | 0
design__max_fanout_violation__count__corner:min_ff_n40C_5v50 | 55
design__max_cap_violation__count__corner:min_ff_n40C_5v50 | 1
clock__skew__worst_hold__corner:min_ff_n40C_5v50 | -0.42942897675514885
clock__skew__worst_setup__corner:min_ff_n40C_5v50 | 0.33524403646461015
timing__hold__ws__corner:min_ff_n40C_5v50 | 0.14114987356224726
timing__setup__ws__corner:min_ff_n40C_5v50 | 9.439373994068522
timing__hold__tns__corner:min_ff_n40C_5v50 | 0.0
timing__setup__tns__corner:min_ff_n40C_5v50 | 0.0
timing__hold__wns__corner:min_ff_n40C_5v50 | 0
timing__setup__wns__corner:min_ff_n40C_5v50 | 0.0
timing__hold_vio__count__corner:min_ff_n40C_5v50 | 0
timing__hold_r2r__ws__corner:min_ff_n40C_5v50 | 0.141150
timing__hold_r2r_vio__count__corner:min_ff_n40C_5v50 | 0
timing__setup_vio__count__corner:min_ff_n40C_5v50 | 0
timing__setup_r2r__ws__corner:min_ff_n40C_5v50 | 9.439374
timing__setup_r2r_vio__count__corner:min_ff_n40C_5v50 | 0
timing__unannotated_net__count__corner:min_ff_n40C_5v50 | 48
timing__unannotated_net_filtered__count__corner:min_ff_n40C_5v50 | 0
design__max_slew_violation__count__corner:max_tt_025C_5v00 | 48
design__max_fanout_violation__count__corner:max_tt_025C_5v00 | 55
design__max_cap_violation__count__corner:max_tt_025C_5v00 | 3
clock__skew__worst_hold__corner:max_tt_025C_5v00 | -0.5429338243775895
clock__skew__worst_setup__corner:max_tt_025C_5v00 | 0.399326666369867
timing__hold__ws__corner:max_tt_025C_5v00 | 0.3980859088380306
timing__setup__ws__corner:max_tt_025C_5v00 | 1.8428690206578093
timing__hold__tns__corner:max_tt_025C_5v00 | 0.0
timing__setup__tns__corner:max_tt_025C_5v00 | 0.0
timing__hold__wns__corner:max_tt_025C_5v00 | 0
timing__setup__wns__corner:max_tt_025C_5v00 | 0.0
timing__hold_vio__count__corner:max_tt_025C_5v00 | 0
timing__hold_r2r__ws__corner:max_tt_025C_5v00 | 0.398086
timing__hold_r2r_vio__count__corner:max_tt_025C_5v00 | 0
timing__setup_vio__count__corner:max_tt_025C_5v00 | 0
timing__setup_r2r__ws__corner:max_tt_025C_5v00 | 1.842869
timing__setup_r2r_vio__count__corner:max_tt_025C_5v00 | 0
timing__unannotated_net__count__corner:max_tt_025C_5v00 | 48
timing__unannotated_net_filtered__count__corner:max_tt_025C_5v00 | 0
design__max_slew_violation__count__corner:max_ss_125C_4v50 | 2125
design__max_fanout_violation__count__corner:max_ss_125C_4v50 | 55
design__max_cap_violation__count__corner:max_ss_125C_4v50 | 3
clock__skew__worst_hold__corner:max_ss_125C_4v50 | -0.7666503204825384
clock__skew__worst_setup__corner:max_ss_125C_4v50 | 0.5214294699162303
timing__hold__ws__corner:max_ss_125C_4v50 | 0.9766563390017252
timing__setup__ws__corner:max_ss_125C_4v50 | -12.460120399249533
timing__hold__tns__corner:max_ss_125C_4v50 | 0.0
timing__setup__tns__corner:max_ss_125C_4v50 | -6475.345527505277
timing__hold__wns__corner:max_ss_125C_4v50 | 0
timing__setup__wns__corner:max_ss_125C_4v50 | -12.460120399249533
timing__hold_vio__count__corner:max_ss_125C_4v50 | 0
timing__hold_r2r__ws__corner:max_ss_125C_4v50 | 0.976656
timing__hold_r2r_vio__count__corner:max_ss_125C_4v50 | 0
timing__setup_vio__count__corner:max_ss_125C_4v50 | 772
timing__setup_r2r__ws__corner:max_ss_125C_4v50 | -12.460120
timing__setup_r2r_vio__count__corner:max_ss_125C_4v50 | 772
timing__unannotated_net__count__corner:max_ss_125C_4v50 | 48
timing__unannotated_net_filtered__count__corner:max_ss_125C_4v50 | 0
design__max_slew_violation__count__corner:max_ff_n40C_5v50 | 0
design__max_fanout_violation__count__corner:max_ff_n40C_5v50 | 55
design__max_cap_violation__count__corner:max_ff_n40C_5v50 | 3
clock__skew__worst_hold__corner:max_ff_n40C_5v50 | -0.44191476728781054
clock__skew__worst_setup__corner:max_ff_n40C_5v50 | 0.34812159695816647
timing__hold__ws__corner:max_ff_n40C_5v50 | 0.15034263148843496
timing__setup__ws__corner:max_ff_n40C_5v50 | 8.256965123119851
timing__hold__tns__corner:max_ff_n40C_5v50 | 0.0
timing__setup__tns__corner:max_ff_n40C_5v50 | 0.0
timing__hold__wns__corner:max_ff_n40C_5v50 | 0
timing__setup__wns__corner:max_ff_n40C_5v50 | 0.0
timing__hold_vio__count__corner:max_ff_n40C_5v50 | 0
timing__hold_r2r__ws__corner:max_ff_n40C_5v50 | 0.150343
timing__hold_r2r_vio__count__corner:max_ff_n40C_5v50 | 0
timing__setup_vio__count__corner:max_ff_n40C_5v50 | 0
timing__setup_r2r__ws__corner:max_ff_n40C_5v50 | 8.256965
timing__setup_r2r_vio__count__corner:max_ff_n40C_5v50 | 0
timing__unannotated_net__count__corner:max_ff_n40C_5v50 | 48
timing__unannotated_net_filtered__count__corner:max_ff_n40C_5v50 | 0
timing__unannotated_net__count | 48
timing__unannotated_net_filtered__count | 0
design_powergrid__voltage__worst__net:VDD__corner:nom_tt_025C_5v00 | 4.99635
design_powergrid__drop__average__net:VDD__corner:nom_tt_025C_5v00 | 4.99936
design_powergrid__drop__worst__net:VDD__corner:nom_tt_025C_5v00 | 0.00365193
design_powergrid__voltage__worst__net:VSS__corner:nom_tt_025C_5v00 | 0.00293273
design_powergrid__drop__average__net:VSS__corner:nom_tt_025C_5v00 | 0.000618333
design_powergrid__drop__worst__net:VSS__corner:nom_tt_025C_5v00 | 0.00293273
design_powergrid__voltage__worst | 0.00293273
design_powergrid__voltage__worst__net:VDD | 4.99635
design_powergrid__drop__worst | 0.00365193
design_powergrid__drop__worst__net:VDD | 0.00365193
design_powergrid__voltage__worst__net:VSS | 0.00293273
design_powergrid__drop__worst__net:VSS | 0.00293273
ir__voltage__worst | 5
ir__drop__avg | 0.000635999999999999955126173123431954081752337515354156494140625
ir__drop__worst | 0.0036500000000000000326128013483639733749441802501678466796875
design__xor_difference__count | 0
magic__drc_error__count | 0
magic__illegal_overlap__count | 0
design__lvs_device_difference__count | 0
design__lvs_net_difference__count | 0
design__lvs_property_fail__count | 0
design__lvs_error__count | 0
design__lvs_unmatched_device__count | 0
design__lvs_unmatched_net__count | 0
design__lvs_unmatched_pin__count | 0
