SantiagoArenas2/Arqui_proyecto3/asic/resultados/predecodificado/metrics.csv

Metric | Value
design__lint_error__count | 0
design__lint_timing_construct__count | 0
design__lint_warning__count | 13
design__inferred_latch__count | 0
design__instance__count | 20370
design__instance__area | 370879
design__instance_unmapped__count | 0
synthesis__check_error__count | 0
design__max_slew_violation__count__corner:nom_tt_025C_5v00 | 35
design__max_fanout_violation__count__corner:nom_tt_025C_5v00 | 60
design__max_cap_violation__count__corner:nom_tt_025C_5v00 | 2
power__internal__total | 0.025911906734108925
power__switching__total | 0.01937183551490307
power__leakage__total | 0.0000022268125121627236
power__total | 0.045285969972610474
clock__skew__worst_hold__corner:nom_tt_025C_5v00 | -0.5397925592628741
clock__skew__worst_setup__corner:nom_tt_025C_5v00 | 0.39875523456293127
timing__hold__ws__corner:nom_tt_025C_5v00 | 0.3734717085744414
timing__setup__ws__corner:nom_tt_025C_5v00 | 72.85855680550635
timing__hold__tns__corner:nom_tt_025C_5v00 | 0.0
timing__setup__tns__corner:nom_tt_025C_5v00 | 0.0
timing__hold__wns__corner:nom_tt_025C_5v00 | 0
timing__setup__wns__corner:nom_tt_025C_5v00 | 0.0
timing__hold_vio__count__corner:nom_tt_025C_5v00 | 0
timing__hold_r2r__ws__corner:nom_tt_025C_5v00 | 0.373472
timing__hold_r2r_vio__count__corner:nom_tt_025C_5v00 | 0
timing__setup_vio__count__corner:nom_tt_025C_5v00 | 0
timing__setup_r2r__ws__corner:nom_tt_025C_5v00 | 73.688957
timing__setup_r2r_vio__count__corner:nom_tt_025C_5v00 | 0
design__max_slew_violation__count__corner:nom_ss_125C_4v50 | 2012
design__max_fanout_violation__count__corner:nom_ss_125C_4v50 | 60
design__max_cap_violation__count__corner:nom_ss_125C_4v50 | 2
clock__skew__worst_hold__corner:nom_ss_125C_4v50 | -0.7578204944733652
clock__skew__worst_setup__corner:nom_ss_125C_4v50 | 0.5106568645813199
timing__hold__ws__corner:nom_ss_125C_4v50 | 0.9335148474015063
timing__setup__ws__corner:nom_ss_125C_4v50 | 51.51322003655076
timing__hold__tns__corner:nom_ss_125C_4v50 | 0.0
timing__setup__tns__corner:nom_ss_125C_4v50 | 0.0
timing__hold__wns__corner:nom_ss_125C_4v50 | 0
timing__setup__wns__corner:nom_ss_125C_4v50 | 0.0
timing__hold_vio__count__corner:nom_ss_125C_4v50 | 0
timing__hold_r2r__ws__corner:nom_ss_125C_4v50 | 0.933515
timing__hold_r2r_vio__count__corner:nom_ss_125C_4v50 | 0
timing__setup_vio__count__corner:nom_ss_125C_4v50 | 0
timing__setup_r2r__ws__corner:nom_ss_125C_4v50 | 51.513222
timing__setup_r2r_vio__count__corner:nom_ss_125C_4v50 | 0
design__max_slew_violation__count__corner:nom_ff_n40C_5v50 | 0
design__max_fanout_violation__count__corner:nom_ff_n40C_5v50 | 60
design__max_cap_violation__count__corner:nom_ff_n40C_5v50 | 2
clock__skew__worst_hold__corner:nom_ff_n40C_5v50 | -0.4409761847162475
clock__skew__worst_setup__corner:nom_ff_n40C_5v50 | 0.3490690613141777
timing__hold__ws__corner:nom_ff_n40C_5v50 | 0.1338827975267339
timing__setup__ws__corner:nom_ff_n40C_5v50 | 75.40787763210294
timing__hold__tns__corner:nom_ff_n40C_5v50 | 0.0
timing__setup__tns__corner:nom_ff_n40C_5v50 | 0.0
timing__hold__wns__corner:nom_ff_n40C_5v50 | 0
timing__setup__wns__corner:nom_ff_n40C_5v50 | 0.0
timing__hold_vio__count__corner:nom_ff_n40C_5v50 | 0
timing__hold_r2r__ws__corner:nom_ff_n40C_5v50 | 0.133883
timing__hold_r2r_vio__count__corner:nom_ff_n40C_5v50 | 0
timing__setup_vio__count__corner:nom_ff_n40C_5v50 | 0
timing__setup_r2r__ws__corner:nom_ff_n40C_5v50 | 83.549713
timing__setup_r2r_vio__count__corner:nom_ff_n40C_5v50 | 0
design__max_slew_violation__count | 2464
design__max_fanout_violation__count | 60
design__max_cap_violation__count | 9
clock__skew__worst_hold | -0.43192664556428695
clock__skew__worst_setup | 0.34203521538715864
timing__hold__ws | 0.12879786490783648
timing__setup__ws | 49.79137598714095
timing__hold__tns | 0.0
timing__setup__tns | 0.0
timing__hold__wns | 0
timing__setup__wns | 0.0
timing__hold_vio__count | 0
timing__hold_r2r__ws | 0.128798
timing__hold_r2r_vio__count | 0
timing__setup_vio__count | 0
timing__setup_r2r__ws | 49.791374
timing__setup_r2r_vio__count | 0
design__die__bbox | 0.0 0.0 623.965 641.885
design__core__bbox | 6.72 15.68 617.12 623.28
design__io | 30
design__die__area | 400514
design__core__area | 370879
design__instance__count__stdcell | 8707
design__instance__area__stdcell | 190326
design__instance__count__macros | 0
design__instance__area__macros | 0
design__instance__count__padcells | 0
design__instance__area__padcells | 0
design__instance__count__cover | 0
design__instance__area__cover | 0
design__instance__utilization | 0.513175
design__instance__utilization__stdcell | 0.513175
design__rows | 155
design__rows:GF018hv5v_mcu_sc7 | 155
design__sites | 168950
design__sites:GF018hv5v_mcu_sc7 | 168950
design__instance__count__class:tie_cell | 1
design__instance__area__class:tie_cell | 8.7808
design__instance__count__class:inverter | 308
design__instance__area__class:inverter | 2704.49
design__instance__count__class:sequential_cell | 915
design__instance__area__class:sequential_cell | 62686.1
design__instance__count__class:multi_input_combinational_cell | 3884
design__instance__area__class:multi_input_combinational_cell | 83757.9
flow__warnings__count | 1
flow__errors__count | 0
flow__warnings__count:ODB-0220 | 1
flow__warnings__type_count | 1
flow__warnings__count:ORD-0039 | 1
design__instance__count__class:endcap_cell | 310
design__instance__area__class:endcap_cell | 1361.02
design__instance__count__class:tap_cell | 2433
design__instance__area__class:tap_cell | 10681.8
design__power_grid_violation__count__net:VSS | 0
design__power_grid_violation__count__net:VDD | 0
design__power_grid_violation__count | 0
timing__drv__floating__nets | 2
timing__drv__floating__pins | 0
design__instance__displacement__total | 40.852
design__instance__displacement__mean | 0.0045
design__instance__displacement__max | 14
route__wirelength__estimated | 329715
design__violations | 0
design__instance__count__class:timing_repair_buffer | 708
design__instance__area__class:timing_repair_buffer | 23321.8
flow__warnings__count:RSZ-0020 | 1
flow__warnings__count:STA-1140 | 6
design__instance__count__class:clock_buffer | 89
design__instance__area__class:clock_buffer | 5132.38
design__instance__count__class:clock_inverter | 37
design__instance__area__class:clock_inverter | 575.142
design__instance__count__setup_buffer | 0
design__instance__count__hold_buffer | 6
global_route__vias | 47
global_route__wirelength | 529006
antenna__violating__nets | 0
antenna__violating__pins | 0
route__antenna_violation__count | 0
antenna_diodes_count | 17
design__instance__count__class:antenna_cell | 22
design__instance__area__class:antenna_cell | 96.5888
route__net | 5896
route__net__special | 2
route__drc_errors__iter:0 | 59
route__wirelength__iter:0 | 386269
route__drc_errors__iter:1 | 12
route__wirelength__iter:1 | 386295
route__drc_errors__iter:2 | 4
route__wirelength__iter:2 | 386293
route__drc_errors__iter:3 | 0
route__wirelength__iter:3 | 386242
route__drc_errors__iter:4 | 0
route__wirelength__iter:4 | 386128
route__drc_errors | 0
route__wirelength | 386242
route__vias | 44445
route__vias__singlecut | 44445
route__vias__multicut | 0
flow__warnings__count:DRT-0349 | 8
design__disconnected_pin__count | 0
design__critical_disconnected_pin__count | 0
route__wirelength__max | 1267.02
design__instance__count__class:fill_cell | 11663
design__instance__area__class:fill_cell | 180553
timing__unannotated_net__count__corner:nom_tt_025C_5v00 | 55
timing__unannotated_net_filtered__count__corner:nom_tt_025C_5v00 | 0
timing__unannotated_net__count__corner:nom_ss_125C_4v50 | 55
timing__unannotated_net_filtered__count__corner:nom_ss_125C_4v50 | 0
timing__unannotated_net__count__corner:nom_ff_n40C_5v50 | 55
timing__unannotated_net_filtered__count__corner:nom_ff_n40C_5v50 | 0
design__max_slew_violation__count__corner:min_tt_025C_5v00 | 0
design__max_fanout_violation__count__corner:min_tt_025C_5v00 | 60
design__max_cap_violation__count__corner:min_tt_025C_5v00 | 2
clock__skew__worst_hold__corner:min_tt_025C_5v00 | -0.5264260287798682
clock__skew__worst_setup__corner:min_tt_025C_5v00 | 0.3884077336361726
timing__hold__ws__corner:min_tt_025C_5v00 | 0.3661104856237772
timing__setup__ws__corner:min_tt_025C_5v00 | 72.99405730904802
timing__hold__tns__corner:min_tt_025C_5v00 | 0.0
timing__setup__tns__corner:min_tt_025C_5v00 | 0.0
timing__hold__wns__corner:min_tt_025C_5v00 | 0
timing__setup__wns__corner:min_tt_025C_5v00 | 0.0
timing__hold_vio__count__corner:min_tt_025C_5v00 | 0
timing__hold_r2r__ws__corner:min_tt_025C_5v00 | 0.366110
timing__hold_r2r_vio__count__corner:min_tt_025C_5v00 | 0
timing__setup_vio__count__corner:min_tt_025C_5v00 | 0
timing__setup_r2r__ws__corner:min_tt_025C_5v00 | 74.503670
timing__setup_r2r_vio__count__corner:min_tt_025C_5v00 | 0
timing__unannotated_net__count__corner:min_tt_025C_5v00 | 55
timing__unannotated_net_filtered__count__corner:min_tt_025C_5v00 | 0
design__max_slew_violation__count__corner:min_ss_125C_4v50 | 1604
design__max_fanout_violation__count__corner:min_ss_125C_4v50 | 60
design__max_cap_violation__count__corner:min_ss_125C_4v50 | 2
clock__skew__worst_hold__corner:min_ss_125C_4v50 | -0.737995019317326
clock__skew__worst_setup__corner:min_ss_125C_4v50 | 0.49266936369452924
timing__hold__ws__corner:min_ss_125C_4v50 | 0.9207914691348553
timing__setup__ws__corner:min_ss_125C_4v50 | 52.93844090710109
timing__hold__tns__corner:min_ss_125C_4v50 | 0.0
timing__setup__tns__corner:min_ss_125C_4v50 | 0.0
timing__hold__wns__corner:min_ss_125C_4v50 | 0
timing__setup__wns__corner:min_ss_125C_4v50 | 0.0
timing__hold_vio__count__corner:min_ss_125C_4v50 | 0
timing__hold_r2r__ws__corner:min_ss_125C_4v50 | 0.920791
timing__hold_r2r_vio__count__corner:min_ss_125C_4v50 | 0
timing__setup_vio__count__corner:min_ss_125C_4v50 | 0
timing__setup_r2r__ws__corner:min_ss_125C_4v50 | 52.938442
timing__setup_r2r_vio__count__corner:min_ss_125C_4v50 | 0
timing__unannotated_net__count__corner:min_ss_125C_4v50 | 55
timing__unannotated_net_filtered__count__corner:min_ss_125C_4v50 | 0
design__max_slew_violation__count__corner:min_ff_n40C_5v50 | 0
design__max_fanout_violation__count__corner:min_ff_n40C_5v50 | 60
design__max_cap_violation__count__corner:min_ff_n40C_5v50 | 2
clock__skew__worst_hold__corner:min_ff_n40C_5v50 | -0.43192664556428695
clock__skew__worst_setup__corner:min_ff_n40C_5v50 | 0.34203521538715864
timing__hold__ws__corner:min_ff_n40C_5v50 | 0.12879786490783648
timing__setup__ws__corner:min_ff_n40C_5v50 | 75.4955799244582
timing__hold__tns__corner:min_ff_n40C_5v50 | 0.0
timing__setup__tns__corner:min_ff_n40C_5v50 | 0.0
timing__hold__wns__corner:min_ff_n40C_5v50 | 0
timing__setup__wns__corner:min_ff_n40C_5v50 | 0.0
timing__hold_vio__count__corner:min_ff_n40C_5v50 | 0
timing__hold_r2r__ws__corner:min_ff_n40C_5v50 | 0.128798
timing__hold_r2r_vio__count__corner:min_ff_n40C_5v50 | 0
timing__setup_vio__count__corner:min_ff_n40C_5v50 | 0
timing__setup_r2r__ws__corner:min_ff_n40C_5v50 | 84.078636
timing__setup_r2r_vio__count__corner:min_ff_n40C_5v50 | 0
timing__unannotated_net__count__corner:min_ff_n40C_5v50 | 55
timing__unannotated_net_filtered__count__corner:min_ff_n40C_5v50 | 0
design__max_slew_violation__count__corner:max_tt_025C_5v00 | 97
design__max_fanout_violation__count__corner:max_tt_025C_5v00 | 60
design__max_cap_violation__count__corner:max_tt_025C_5v00 | 9
clock__skew__worst_hold__corner:max_tt_025C_5v00 | -0.5560644324611902
clock__skew__worst_setup__corner:max_tt_025C_5v00 | 0.411379247866068
timing__hold__ws__corner:max_tt_025C_5v00 | 0.3794431543035743
timing__setup__ws__corner:max_tt_025C_5v00 | 72.69670937657756
timing__hold__tns__corner:max_tt_025C_5v00 | 0.0
timing__setup__tns__corner:max_tt_025C_5v00 | 0.0
timing__hold__wns__corner:max_tt_025C_5v00 | 0
timing__setup__wns__corner:max_tt_025C_5v00 | 0.0
timing__hold_vio__count__corner:max_tt_025C_5v00 | 0
timing__hold_r2r__ws__corner:max_tt_025C_5v00 | 0.379443
timing__hold_r2r_vio__count__corner:max_tt_025C_5v00 | 0
timing__setup_vio__count__corner:max_tt_025C_5v00 | 0
timing__setup_r2r__ws__corner:max_tt_025C_5v00 | 72.716103
timing__setup_r2r_vio__count__corner:max_tt_025C_5v00 | 0
timing__unannotated_net__count__corner:max_tt_025C_5v00 | 55
timing__unannotated_net_filtered__count__corner:max_tt_025C_5v00 | 0
design__max_slew_violation__count__corner:max_ss_125C_4v50 | 2464
design__max_fanout_violation__count__corner:max_ss_125C_4v50 | 60
design__max_cap_violation__count__corner:max_ss_125C_4v50 | 9
clock__skew__worst_hold__corner:max_ss_125C_4v50 | -0.785323162061813
clock__skew__worst_setup__corner:max_ss_125C_4v50 | 0.5322495927979386
timing__hold__ws__corner:max_ss_125C_4v50 | 0.9489072018948399
timing__setup__ws__corner:max_ss_125C_4v50 | 49.79137598714095
timing__hold__tns__corner:max_ss_125C_4v50 | 0.0
timing__setup__tns__corner:max_ss_125C_4v50 | 0.0
timing__hold__wns__corner:max_ss_125C_4v50 | 0
timing__setup__wns__corner:max_ss_125C_4v50 | 0.0
timing__hold_vio__count__corner:max_ss_125C_4v50 | 0
timing__hold_r2r__ws__corner:max_ss_125C_4v50 | 0.948907
timing__hold_r2r_vio__count__corner:max_ss_125C_4v50 | 0
timing__setup_vio__count__corner:max_ss_125C_4v50 | 0
timing__setup_r2r__ws__corner:max_ss_125C_4v50 | 49.791374
timing__setup_r2r_vio__count__corner:max_ss_125C_4v50 | 0
timing__unannotated_net__count__corner:max_ss_125C_4v50 | 55
timing__unannotated_net_filtered__count__corner:max_ss_125C_4v50 | 0
design__max_slew_violation__count__corner:max_ff_n40C_5v50 | 0
design__max_fanout_violation__count__corner:max_ff_n40C_5v50 | 60
design__max_cap_violation__count__corner:max_ff_n40C_5v50 | 9
clock__skew__worst_hold__corner:max_ff_n40C_5v50 | -0.4519766078222542
clock__skew__worst_setup__corner:max_ff_n40C_5v50 | 0.3577293562626961
timing__hold__ws__corner:max_ff_n40C_5v50 | 0.13620804869527142
timing__setup__ws__corner:max_ff_n40C_5v50 | 75.30288072907015
timing__hold__tns__corner:max_ff_n40C_5v50 | 0.0
timing__setup__tns__corner:max_ff_n40C_5v50 | 0.0
timing__hold__wns__corner:max_ff_n40C_5v50 | 0
timing__setup__wns__corner:max_ff_n40C_5v50 | 0.0
timing__hold_vio__count__corner:max_ff_n40C_5v50 | 0
timing__hold_r2r__ws__corner:max_ff_n40C_5v50 | 0.136208
timing__hold_r2r_vio__count__corner:max_ff_n40C_5v50 | 0
timing__setup_vio__count__corner:max_ff_n40C_5v50 | 0
timing__setup_r2r__ws__corner:max_ff_n40C_5v50 | 82.920143
timing__setup_r2r_vio__count__corner:max_ff_n40C_5v50 | 0
timing__unannotated_net__count__corner:max_ff_n40C_5v50 | 55
timing__unannotated_net_filtered__count__corner:max_ff_n40C_5v50 | 0
timing__unannotated_net__count | 55
timing__unannotated_net_filtered__count | 0
design_powergrid__voltage__worst__net:VDD__corner:nom_tt_025C_5v00 | 4.99953
design_powergrid__drop__average__net:VDD__corner:nom_tt_025C_5v00 | 4.99988
design_powergrid__drop__worst__net:VDD__corner:nom_tt_025C_5v00 | 0.000470315
design_powergrid__voltage__worst__net:VSS__corner:nom_tt_025C_5v00 | 0.000355171
design_powergrid__drop__average__net:VSS__corner:nom_tt_025C_5v00 | 0.00011534
design_powergrid__drop__worst__net:VSS__corner:nom_tt_025C_5v00 | 0.000355171
design_powergrid__voltage__worst | 0.000355171
design_powergrid__voltage__worst__net:VDD | 4.99953
design_powergrid__drop__worst | 0.000470315
design_powergrid__drop__worst__net:VDD | 0.000470315
design_powergrid__voltage__worst__net:VSS | 0.000355171
design_powergrid__drop__worst__net:VSS | 0.000355171
ir__voltage__worst | 5
ir__drop__avg | 0.000119000000000000005838211858399944276243331842124462127685546875
ir__drop__worst | 0.0004699999999999999859313926098280944643192924559116363525390625
design__xor_difference__count | 0
magic__drc_error__count | 0
magic__illegal_overlap__count | 0
design__lvs_device_difference__count | 0
design__lvs_net_difference__count | 0
design__lvs_property_fail__count | 0
design__lvs_error__count | 0
design__lvs_unmatched_device__count | 0
design__lvs_unmatched_net__count | 0
design__lvs_unmatched_pin__count | 0
