SantiagoArenas2/Arqui_proyecto3/asic/resultados/util_55/metrics.csv

Metric | Value
design__lint_error__count | 0
design__lint_timing_construct__count | 0
design__lint_warning__count | 13
design__inferred_latch__count | 0
design__instance__count | 15408
design__instance__area | 260548
design__instance_unmapped__count | 0
synthesis__check_error__count | 0
design__max_slew_violation__count__corner:nom_tt_025C_5v00 | 0
design__max_fanout_violation__count__corner:nom_tt_025C_5v00 | 51
design__max_cap_violation__count__corner:nom_tt_025C_5v00 | 1
power__internal__total | 0.024870464578270912
power__switching__total | 0.018795199692249298
power__leakage__total | 0.0000018836224171536742
power__total | 0.04366754740476608
clock__skew__worst_hold__corner:nom_tt_025C_5v00 | -0.5222155078398957
clock__skew__worst_setup__corner:nom_tt_025C_5v00 | 0.3952087935439197
timing__hold__ws__corner:nom_tt_025C_5v00 | 0.3724334279724474
timing__setup__ws__corner:nom_tt_025C_5v00 | 65.29441705462486
timing__hold__tns__corner:nom_tt_025C_5v00 | 0.0
timing__setup__tns__corner:nom_tt_025C_5v00 | 0.0
timing__hold__wns__corner:nom_tt_025C_5v00 | 0
timing__setup__wns__corner:nom_tt_025C_5v00 | 0.0
timing__hold_vio__count__corner:nom_tt_025C_5v00 | 0
timing__hold_r2r__ws__corner:nom_tt_025C_5v00 | 0.372433
timing__hold_r2r_vio__count__corner:nom_tt_025C_5v00 | 0
timing__setup_vio__count__corner:nom_tt_025C_5v00 | 0
timing__setup_r2r__ws__corner:nom_tt_025C_5v00 | 65.294418
timing__setup_r2r_vio__count__corner:nom_tt_025C_5v00 | 0
design__max_slew_violation__count__corner:nom_ss_125C_4v50 | 1513
design__max_fanout_violation__count__corner:nom_ss_125C_4v50 | 51
design__max_cap_violation__count__corner:nom_ss_125C_4v50 | 1
clock__skew__worst_hold__corner:nom_ss_125C_4v50 | -0.7301219835378345
clock__skew__worst_setup__corner:nom_ss_125C_4v50 | 0.5077135522374936
timing__hold__ws__corner:nom_ss_125C_4v50 | 0.9319867363871943
timing__setup__ws__corner:nom_ss_125C_4v50 | 36.24148195238053
timing__hold__tns__corner:nom_ss_125C_4v50 | 0.0
timing__setup__tns__corner:nom_ss_125C_4v50 | 0.0
timing__hold__wns__corner:nom_ss_125C_4v50 | 0
timing__setup__wns__corner:nom_ss_125C_4v50 | 0.0
timing__hold_vio__count__corner:nom_ss_125C_4v50 | 0
timing__hold_r2r__ws__corner:nom_ss_125C_4v50 | 0.931987
timing__hold_r2r_vio__count__corner:nom_ss_125C_4v50 | 0
timing__setup_vio__count__corner:nom_ss_125C_4v50 | 0
timing__setup_r2r__ws__corner:nom_ss_125C_4v50 | 36.241482
timing__setup_r2r_vio__count__corner:nom_ss_125C_4v50 | 0
design__max_slew_violation__count__corner:nom_ff_n40C_5v50 | 0
design__max_fanout_violation__count__corner:nom_ff_n40C_5v50 | 51
design__max_cap_violation__count__corner:nom_ff_n40C_5v50 | 1
clock__skew__worst_hold__corner:nom_ff_n40C_5v50 | -0.42837293258425846
clock__skew__worst_setup__corner:nom_ff_n40C_5v50 | 0.343732330106174
timing__hold__ws__corner:nom_ff_n40C_5v50 | 0.13280299458244454
timing__setup__ws__corner:nom_ff_n40C_5v50 | 75.61147655336582
timing__hold__tns__corner:nom_ff_n40C_5v50 | 0.0
timing__setup__tns__corner:nom_ff_n40C_5v50 | 0.0
timing__hold__wns__corner:nom_ff_n40C_5v50 | 0
timing__setup__wns__corner:nom_ff_n40C_5v50 | 0.0
timing__hold_vio__count__corner:nom_ff_n40C_5v50 | 0
timing__hold_r2r__ws__corner:nom_ff_n40C_5v50 | 0.132803
timing__hold_r2r_vio__count__corner:nom_ff_n40C_5v50 | 0
timing__setup_vio__count__corner:nom_ff_n40C_5v50 | 0
timing__setup_r2r__ws__corner:nom_ff_n40C_5v50 | 78.181694
timing__setup_r2r_vio__count__corner:nom_ff_n40C_5v50 | 0
design__max_slew_violation__count | 2098
design__max_fanout_violation__count | 51
design__max_cap_violation__count | 2
clock__skew__worst_hold | -0.4230451386718557
clock__skew__worst_setup | 0.33633136117010404
timing__hold__ws | 0.13016998958277706
timing__setup__ws | 34.10552647943051
timing__hold__tns | 0.0
timing__setup__tns | 0.0
timing__hold__wns | 0
timing__setup__wns | 0.0
timing__hold_vio__count | 0
timing__hold_r2r__ws | 0.130170
timing__hold_r2r_vio__count | 0
timing__setup_vio__count | 0
timing__setup_r2r__ws | 34.105526
timing__setup_r2r_vio__count | 0
design__die__bbox | 0.0 0.0 524.94 542.86
design__core__bbox | 6.72 15.68 518.0 525.28
design__io | 30
design__die__area | 284969
design__core__area | 260548
design__instance__count__stdcell | 7840
design__instance__area__stdcell | 180239
design__instance__count__macros | 0
design__instance__area__macros | 0
design__instance__count__padcells | 0
design__instance__area__padcells | 0
design__instance__count__cover | 0
design__instance__area__cover | 0
design__instance__utilization | 0.691768
design__instance__utilization__stdcell | 0.691768
design__rows | 130
design__rows:GF018hv5v_mcu_sc7 | 130
design__sites | 118690
design__sites:GF018hv5v_mcu_sc7 | 118690
design__instance__count__class:tie_cell | 1
design__instance__area__class:tie_cell | 8.7808
design__instance__count__class:inverter | 325
design__instance__area__class:inverter | 2853.76
design__instance__count__class:sequential_cell | 846
design__instance__area__class:sequential_cell | 57536.2
design__instance__count__class:multi_input_combinational_cell | 3901
design__instance__area__class:multi_input_combinational_cell | 83525.2
flow__warnings__count | 1
flow__errors__count | 0
flow__warnings__count:ODB-0220 | 1
flow__warnings__type_count | 1
flow__warnings__count:ORD-0039 | 1
design__instance__count__class:endcap_cell | 260
design__instance__area__class:endcap_cell | 1141.5
design__instance__count__class:tap_cell | 1716
design__instance__area__class:tap_cell | 7533.93
design__power_grid_violation__count__net:VSS | 0
design__power_grid_violation__count__net:VDD | 0
design__power_grid_violation__count | 0
timing__drv__floating__nets | 2
timing__drv__floating__pins | 0
design__instance__displacement__total | 618.435
design__instance__displacement__mean | 0.0785
design__instance__displacement__max | 30.8
route__wirelength__estimated | 288320
design__violations | 0
design__instance__count__class:timing_repair_buffer | 676
design__instance__area__class:timing_repair_buffer | 22520.6
flow__warnings__count:RSZ-0020 | 1
flow__warnings__count:STA-1140 | 6
design__instance__count__class:clock_buffer | 86
design__instance__area__class:clock_buffer | 4684.56
design__instance__count__class:clock_inverter | 24
design__instance__area__class:clock_inverter | 412.698
design__instance__count__setup_buffer | 0
design__instance__count__hold_buffer | 7
global_route__vias | 28
global_route__wirelength | 479799
antenna__violating__nets | 0
antenna__violating__pins | 0
route__antenna_violation__count | 0
antenna_diodes_count | 5
route__net | 5820
route__net__special | 2
route__drc_errors__iter:0 | 29
route__wirelength__iter:0 | 334057
route__drc_errors__iter:1 | 1
route__wirelength__iter:1 | 334052
route__drc_errors__iter:2 | 0
route__wirelength__iter:2 | 334048
route__drc_errors__iter:3 | 0
route__wirelength__iter:3 | 334056
route__drc_errors__iter:4 | 0
route__wirelength__iter:4 | 334010
route__drc_errors | 0
route__wirelength | 334048
route__vias | 43449
route__vias__singlecut | 43449
route__vias__multicut | 0
design__instance__count__class:antenna_cell | 5
design__instance__area__class:antenna_cell | 21.952
flow__warnings__count:DRT-0349 | 8
design__disconnected_pin__count | 0
design__critical_disconnected_pin__count | 0
route__wirelength__max | 801.81
design__instance__count__class:fill_cell | 7568
design__instance__area__class:fill_cell | 80309.2
timing__unannotated_net__count__corner:nom_tt_025C_5v00 | 48
timing__unannotated_net_filtered__count__corner:nom_tt_025C_5v00 | 0
timing__unannotated_net__count__corner:nom_ss_125C_4v50 | 48
timing__unannotated_net_filtered__count__corner:nom_ss_125C_4v50 | 0
timing__unannotated_net__count__corner:nom_ff_n40C_5v50 | 48
timing__unannotated_net_filtered__count__corner:nom_ff_n40C_5v50 | 0
design__max_slew_violation__count__corner:min_tt_025C_5v00 | 0
design__max_fanout_violation__count__corner:min_tt_025C_5v00 | 51
design__max_cap_violation__count__corner:min_tt_025C_5v00 | 1
clock__skew__worst_hold__corner:min_tt_025C_5v00 | -0.5143957627670933
clock__skew__worst_setup__corner:min_tt_025C_5v00 | 0.38389334464576613
timing__hold__ws__corner:min_tt_025C_5v00 | 0.3687125154001816
timing__setup__ws__corner:min_tt_025C_5v00 | 66.30192404986278
timing__hold__tns__corner:min_tt_025C_5v00 | 0.0
timing__setup__tns__corner:min_tt_025C_5v00 | 0.0
timing__hold__wns__corner:min_tt_025C_5v00 | 0
timing__setup__wns__corner:min_tt_025C_5v00 | 0.0
timing__hold_vio__count__corner:min_tt_025C_5v00 | 0
timing__hold_r2r__ws__corner:min_tt_025C_5v00 | 0.368713
timing__hold_r2r_vio__count__corner:min_tt_025C_5v00 | 0
timing__setup_vio__count__corner:min_tt_025C_5v00 | 0
timing__setup_r2r__ws__corner:min_tt_025C_5v00 | 66.301926
timing__setup_r2r_vio__count__corner:min_tt_025C_5v00 | 0
timing__unannotated_net__count__corner:min_tt_025C_5v00 | 48
timing__unannotated_net_filtered__count__corner:min_tt_025C_5v00 | 0
design__max_slew_violation__count__corner:min_ss_125C_4v50 | 1085
design__max_fanout_violation__count__corner:min_ss_125C_4v50 | 51
design__max_cap_violation__count__corner:min_ss_125C_4v50 | 1
clock__skew__worst_hold__corner:min_ss_125C_4v50 | -0.7169831598036193
clock__skew__worst_setup__corner:min_ss_125C_4v50 | 0.4880692654841977
timing__hold__ws__corner:min_ss_125C_4v50 | 0.9256742301352507
timing__setup__ws__corner:min_ss_125C_4v50 | 37.99104427469627
timing__hold__tns__corner:min_ss_125C_4v50 | 0.0
timing__setup__tns__corner:min_ss_125C_4v50 | 0.0
timing__hold__wns__corner:min_ss_125C_4v50 | 0
timing__setup__wns__corner:min_ss_125C_4v50 | 0.0
timing__hold_vio__count__corner:min_ss_125C_4v50 | 0
timing__hold_r2r__ws__corner:min_ss_125C_4v50 | 0.925674
timing__hold_r2r_vio__count__corner:min_ss_125C_4v50 | 0
timing__setup_vio__count__corner:min_ss_125C_4v50 | 0
timing__setup_r2r__ws__corner:min_ss_125C_4v50 | 37.991043
timing__setup_r2r_vio__count__corner:min_ss_125C_4v50 | 0
timing__unannotated_net__count__corner:min_ss_125C_4v50 | 48
timing__unannotated_net_filtered__count__corner:min_ss_125C_4v50 | 0
design__max_slew_violation__count__corner:min_ff_n40C_5v50 | 0
design__max_fanout_violation__count__corner:min_ff_n40C_5v50 | 51
design__max_cap_violation__count__corner:min_ff_n40C_5v50 | 1
clock__skew__worst_hold__corner:min_ff_n40C_5v50 | -0.4230451386718557
clock__skew__worst_setup__corner:min_ff_n40C_5v50 | 0.33633136117010404
timing__hold__ws__corner:min_ff_n40C_5v50 | 0.13016998958277706
timing__setup__ws__corner:min_ff_n40C_5v50 | 75.6792196997091
timing__hold__tns__corner:min_ff_n40C_5v50 | 0.0
timing__setup__tns__corner:min_ff_n40C_5v50 | 0.0
timing__hold__wns__corner:min_ff_n40C_5v50 | 0
timing__setup__wns__corner:min_ff_n40C_5v50 | 0.0
timing__hold_vio__count__corner:min_ff_n40C_5v50 | 0
timing__hold_r2r__ws__corner:min_ff_n40C_5v50 | 0.130170
timing__hold_r2r_vio__count__corner:min_ff_n40C_5v50 | 0
timing__setup_vio__count__corner:min_ff_n40C_5v50 | 0
timing__setup_r2r__ws__corner:min_ff_n40C_5v50 | 78.840424
timing__setup_r2r_vio__count__corner:min_ff_n40C_5v50 | 0
timing__unannotated_net__count__corner:min_ff_n40C_5v50 | 48
timing__unannotated_net_filtered__count__corner:min_ff_n40C_5v50 | 0
design__max_slew_violation__count__corner:max_tt_025C_5v00 | 22
design__max_fanout_violation__count__corner:max_tt_025C_5v00 | 51
design__max_cap_violation__count__corner:max_tt_025C_5v00 | 2
clock__skew__worst_hold__corner:max_tt_025C_5v00 | -0.5317290092069688
clock__skew__worst_setup__corner:max_tt_025C_5v00 | 0.40855711636880676
timing__hold__ws__corner:max_tt_025C_5v00 | 0.3767707363854179
timing__setup__ws__corner:max_tt_025C_5v00 | 64.06834710768575
timing__hold__tns__corner:max_tt_025C_5v00 | 0.0
timing__setup__tns__corner:max_tt_025C_5v00 | 0.0
timing__hold__wns__corner:max_tt_025C_5v00 | 0
timing__setup__wns__corner:max_tt_025C_5v00 | 0.0
timing__hold_vio__count__corner:max_tt_025C_5v00 | 0
timing__hold_r2r__ws__corner:max_tt_025C_5v00 | 0.376771
timing__hold_r2r_vio__count__corner:max_tt_025C_5v00 | 0
timing__setup_vio__count__corner:max_tt_025C_5v00 | 0
timing__setup_r2r__ws__corner:max_tt_025C_5v00 | 64.068344
timing__setup_r2r_vio__count__corner:max_tt_025C_5v00 | 0
timing__unannotated_net__count__corner:max_tt_025C_5v00 | 48
timing__unannotated_net_filtered__count__corner:max_tt_025C_5v00 | 0
design__max_slew_violation__count__corner:max_ss_125C_4v50 | 2098
design__max_fanout_violation__count__corner:max_ss_125C_4v50 | 51
design__max_cap_violation__count__corner:max_ss_125C_4v50 | 2
clock__skew__worst_hold__corner:max_ss_125C_4v50 | -0.7462293216792479
clock__skew__worst_setup__corner:max_ss_125C_4v50 | 0.5311047307825663
timing__hold__ws__corner:max_ss_125C_4v50 | 0.9393532884085275
timing__setup__ws__corner:max_ss_125C_4v50 | 34.10552647943051
timing__hold__tns__corner:max_ss_125C_4v50 | 0.0
timing__setup__tns__corner:max_ss_125C_4v50 | 0.0
timing__hold__wns__corner:max_ss_125C_4v50 | 0
timing__setup__wns__corner:max_ss_125C_4v50 | 0.0
timing__hold_vio__count__corner:max_ss_125C_4v50 | 0
timing__hold_r2r__ws__corner:max_ss_125C_4v50 | 0.939353
timing__hold_r2r_vio__count__corner:max_ss_125C_4v50 | 0
timing__setup_vio__count__corner:max_ss_125C_4v50 | 0
timing__setup_r2r__ws__corner:max_ss_125C_4v50 | 34.105526
timing__setup_r2r_vio__count__corner:max_ss_125C_4v50 | 0
timing__unannotated_net__count__corner:max_ss_125C_4v50 | 48
timing__unannotated_net_filtered__count__corner:max_ss_125C_4v50 | 0
design__max_slew_violation__count__corner:max_ff_n40C_5v50 | 0
design__max_fanout_violation__count__corner:max_ff_n40C_5v50 | 51
design__max_cap_violation__count__corner:max_ff_n40C_5v50 | 2
clock__skew__worst_hold__corner:max_ff_n40C_5v50 | -0.4349263017282065
clock__skew__worst_setup__corner:max_ff_n40C_5v50 | 0.35279152819872195
timing__hold__ws__corner:max_ff_n40C_5v50 | 0.1358664330609327
timing__setup__ws__corner:max_ff_n40C_5v50 | 75.53001993183453
timing__hold__tns__corner:max_ff_n40C_5v50 | 0.0
timing__setup__tns__corner:max_ff_n40C_5v50 | 0.0
timing__hold__wns__corner:max_ff_n40C_5v50 | 0
timing__setup__wns__corner:max_ff_n40C_5v50 | 0.0
timing__hold_vio__count__corner:max_ff_n40C_5v50 | 0
timing__hold_r2r__ws__corner:max_ff_n40C_5v50 | 0.135866
timing__hold_r2r_vio__count__corner:max_ff_n40C_5v50 | 0
timing__setup_vio__count__corner:max_ff_n40C_5v50 | 0
timing__setup_r2r__ws__corner:max_ff_n40C_5v50 | 77.381683
timing__setup_r2r_vio__count__corner:max_ff_n40C_5v50 | 0
timing__unannotated_net__count__corner:max_ff_n40C_5v50 | 48
timing__unannotated_net_filtered__count__corner:max_ff_n40C_5v50 | 0
timing__unannotated_net__count | 48
timing__unannotated_net_filtered__count | 0
design_powergrid__voltage__worst__net:VDD__corner:nom_tt_025C_5v00 | 4.99969
design_powergrid__drop__average__net:VDD__corner:nom_tt_025C_5v00 | 4.99987
design_powergrid__drop__worst__net:VDD__corner:nom_tt_025C_5v00 | 0.000307294
design_powergrid__voltage__worst__net:VSS__corner:nom_tt_025C_5v00 | 0.00029956
design_powergrid__drop__average__net:VSS__corner:nom_tt_025C_5v00 | 0.000130241
design_powergrid__drop__worst__net:VSS__corner:nom_tt_025C_5v00 | 0.00029956
design_powergrid__voltage__worst | 0.00029956
design_powergrid__voltage__worst__net:VDD | 4.99969
design_powergrid__drop__worst | 0.000307294
design_powergrid__drop__worst__net:VDD | 0.000307294
design_powergrid__voltage__worst__net:VSS | 0.00029956
design_powergrid__drop__worst__net:VSS | 0.00029956
ir__voltage__worst | 5
ir__drop__avg | 0.00013300000000000000732226779209810274551273323595523834228515625
ir__drop__worst | 0.00030699999999999998123723088383485446684062480926513671875
design__xor_difference__count | 0
magic__drc_error__count | 0
magic__illegal_overlap__count | 0
design__lvs_device_difference__count | 0
design__lvs_net_difference__count | 0
design__lvs_property_fail__count | 0
design__lvs_error__count | 0
design__lvs_unmatched_device__count | 0
design__lvs_unmatched_net__count | 0
design__lvs_unmatched_pin__count | 0
