SantiagoArenas2/Arqui_proyecto3/asic/resultados/util_70/metrics.csv

Metric | Value
design__lint_error__count | 0
design__lint_timing_construct__count | 0
design__lint_warning__count | 13
design__inferred_latch__count | 0
design__instance__count | 11416
design__instance__area | 204230
design__instance_unmapped__count | 0
synthesis__check_error__count | 0
design__max_slew_violation__count__corner:nom_tt_025C_5v00 | 6
design__max_fanout_violation__count__corner:nom_tt_025C_5v00 | 49
design__max_cap_violation__count__corner:nom_tt_025C_5v00 | 1
power__internal__total | 0.02495768666267395
power__switching__total | 0.020211374387145042
power__leakage__total | 0.0000016402257188019576
power__total | 0.045170702040195465
clock__skew__worst_hold__corner:nom_tt_025C_5v00 | -0.5255844797034017
clock__skew__worst_setup__corner:nom_tt_025C_5v00 | 0.4217711577150677
timing__hold__ws__corner:nom_tt_025C_5v00 | 0.37240900306521485
timing__setup__ws__corner:nom_tt_025C_5v00 | 66.96022059688033
timing__hold__tns__corner:nom_tt_025C_5v00 | 0.0
timing__setup__tns__corner:nom_tt_025C_5v00 | 0.0
timing__hold__wns__corner:nom_tt_025C_5v00 | 0
timing__setup__wns__corner:nom_tt_025C_5v00 | 0.0
timing__hold_vio__count__corner:nom_tt_025C_5v00 | 0
timing__hold_r2r__ws__corner:nom_tt_025C_5v00 | 0.372409
timing__hold_r2r_vio__count__corner:nom_tt_025C_5v00 | 0
timing__setup_vio__count__corner:nom_tt_025C_5v00 | 0
timing__setup_r2r__ws__corner:nom_tt_025C_5v00 | 66.960220
timing__setup_r2r_vio__count__corner:nom_tt_025C_5v00 | 0
design__max_slew_violation__count__corner:nom_ss_125C_4v50 | 1742
design__max_fanout_violation__count__corner:nom_ss_125C_4v50 | 49
design__max_cap_violation__count__corner:nom_ss_125C_4v50 | 1
clock__skew__worst_hold__corner:nom_ss_125C_4v50 | -0.7435781090214616
clock__skew__worst_setup__corner:nom_ss_125C_4v50 | 0.556843920068825
timing__hold__ws__corner:nom_ss_125C_4v50 | 0.9311616186119569
timing__setup__ws__corner:nom_ss_125C_4v50 | 39.21584945552996
timing__hold__tns__corner:nom_ss_125C_4v50 | 0.0
timing__setup__tns__corner:nom_ss_125C_4v50 | 0.0
timing__hold__wns__corner:nom_ss_125C_4v50 | 0
timing__setup__wns__corner:nom_ss_125C_4v50 | 0.0
timing__hold_vio__count__corner:nom_ss_125C_4v50 | 0
timing__hold_r2r__ws__corner:nom_ss_125C_4v50 | 0.931162
timing__hold_r2r_vio__count__corner:nom_ss_125C_4v50 | 0
timing__setup_vio__count__corner:nom_ss_125C_4v50 | 0
timing__setup_r2r__ws__corner:nom_ss_125C_4v50 | 39.215851
timing__setup_r2r_vio__count__corner:nom_ss_125C_4v50 | 0
design__max_slew_violation__count__corner:nom_ff_n40C_5v50 | 0
design__max_fanout_violation__count__corner:nom_ff_n40C_5v50 | 49
design__max_cap_violation__count__corner:nom_ff_n40C_5v50 | 1
clock__skew__worst_hold__corner:nom_ff_n40C_5v50 | -0.4289130561010143
clock__skew__worst_setup__corner:nom_ff_n40C_5v50 | 0.3596210930834325
timing__hold__ws__corner:nom_ff_n40C_5v50 | 0.13396339972060126
timing__setup__ws__corner:nom_ff_n40C_5v50 | 75.6434012393864
timing__hold__tns__corner:nom_ff_n40C_5v50 | 0.0
timing__setup__tns__corner:nom_ff_n40C_5v50 | 0.0
timing__hold__wns__corner:nom_ff_n40C_5v50 | 0
timing__setup__wns__corner:nom_ff_n40C_5v50 | 0.0
timing__hold_vio__count__corner:nom_ff_n40C_5v50 | 0
timing__hold_r2r__ws__corner:nom_ff_n40C_5v50 | 0.133963
timing__hold_r2r_vio__count__corner:nom_ff_n40C_5v50 | 0
timing__setup_vio__count__corner:nom_ff_n40C_5v50 | 0
timing__setup_r2r__ws__corner:nom_ff_n40C_5v50 | 79.256920
timing__setup_r2r_vio__count__corner:nom_ff_n40C_5v50 | 0
design__max_slew_violation__count | 2311
design__max_fanout_violation__count | 49
design__max_cap_violation__count | 3
clock__skew__worst_hold | -0.42337315407375814
clock__skew__worst_setup | 0.35127737823933947
timing__hold__ws | 0.12905943345983584
timing__setup__ws | 36.69131236025761
timing__hold__tns | 0.0
timing__setup__tns | 0.0
timing__hold__wns | 0
timing__setup__wns | 0.0
timing__hold_vio__count | 0
timing__hold_r2r__ws | 0.129059
timing__hold_r2r_vio__count | 0
timing__setup_vio__count | 0
timing__setup_r2r__ws | 36.691311
timing__setup_r2r_vio__count | 0
design__die__bbox | 0.0 0.0 466.835 484.755
design__core__bbox | 6.72 15.68 459.76 466.48
design__io | 30
design__die__area | 226301
design__core__area | 204230
design__instance__count__stdcell | 7425
design__instance__area__stdcell | 178180
design__instance__count__macros | 0
design__instance__area__macros | 0
design__instance__count__padcells | 0
design__instance__area__padcells | 0
design__instance__count__cover | 0
design__instance__area__cover | 0
design__instance__utilization | 0.872446
design__instance__utilization__stdcell | 0.872446
design__rows | 115
design__rows:GF018hv5v_mcu_sc7 | 115
design__sites | 93035
design__sites:GF018hv5v_mcu_sc7 | 93035
design__instance__count__class:tie_cell | 1
design__instance__area__class:tie_cell | 8.7808
design__instance__count__class:inverter | 325
design__instance__area__class:inverter | 2853.76
design__instance__count__class:sequential_cell | 846
design__instance__area__class:sequential_cell | 57536.2
design__instance__count__class:multi_input_combinational_cell | 3901
design__instance__area__class:multi_input_combinational_cell | 83525.2
flow__warnings__count | 1
flow__errors__count | 0
flow__warnings__count:ODB-0220 | 1
flow__warnings__type_count | 1
flow__warnings__count:ORD-0039 | 1
design__instance__count__class:endcap_cell | 230
design__instance__area__class:endcap_cell | 1009.79
design__instance__count__class:tap_cell | 1345
design__instance__area__class:tap_cell | 5905.09
design__power_grid_violation__count__net:VSS | 0
design__power_grid_violation__count__net:VDD | 0
design__power_grid_violation__count | 0
timing__drv__floating__nets | 2
timing__drv__floating__pins | 0
design__instance__displacement__total | 3225.12
design__instance__displacement__mean | 0.4345
design__instance__displacement__max | 105.84
route__wirelength__estimated | 328854
design__violations | 0
design__instance__count__class:timing_repair_buffer | 665
design__instance__area__class:timing_repair_buffer | 22257.1
flow__warnings__count:RSZ-0020 | 1
flow__warnings__count:STA-1140 | 6
design__instance__count__class:clock_buffer | 85
design__instance__area__class:clock_buffer | 4667
design__instance__count__class:clock_inverter | 23
design__instance__area__class:clock_inverter | 399.526
design__instance__count__setup_buffer | 0
design__instance__count__hold_buffer | 7
global_route__vias | 15
global_route__wirelength | 531157
antenna__violating__nets | 1
antenna__violating__pins | 1
route__antenna_violation__count | 1
antenna_diodes_count | 4
route__net | 5807
route__net__special | 2
route__drc_errors__iter:0 | 47
route__wirelength__iter:0 | 372937
route__drc_errors__iter:1 | 4
route__wirelength__iter:1 | 372898
route__drc_errors__iter:2 | 3
route__wirelength__iter:2 | 372897
route__drc_errors__iter:3 | 0
route__wirelength__iter:3 | 372891
route__drc_errors__iter:4 | 2
route__wirelength__iter:4 | 372799
route__drc_errors__iter:5 | 2
route__wirelength__iter:5 | 372799
route__drc_errors__iter:6 | 0
route__wirelength__iter:6 | 372801
route__drc_errors | 0
route__wirelength | 372891
route__vias | 47260
route__vias__singlecut | 47260
route__vias__multicut | 0
design__instance__count__class:antenna_cell | 4
design__instance__area__class:antenna_cell | 17.5616
flow__warnings__count:DRT-0349 | 8
design__disconnected_pin__count | 0
design__critical_disconnected_pin__count | 0
route__wirelength__max | 809.75
design__instance__count__class:fill_cell | 3991
design__instance__area__class:fill_cell | 26050.4
timing__unannotated_net__count__corner:nom_tt_025C_5v00 | 48
timing__unannotated_net_filtered__count__corner:nom_tt_025C_5v00 | 0
timing__unannotated_net__count__corner:nom_ss_125C_4v50 | 48
timing__unannotated_net_filtered__count__corner:nom_ss_125C_4v50 | 0
timing__unannotated_net__count__corner:nom_ff_n40C_5v50 | 48
timing__unannotated_net_filtered__count__corner:nom_ff_n40C_5v50 | 0
design__max_slew_violation__count__corner:min_tt_025C_5v00 | 0
design__max_fanout_violation__count__corner:min_tt_025C_5v00 | 49
design__max_cap_violation__count__corner:min_tt_025C_5v00 | 1
clock__skew__worst_hold__corner:min_tt_025C_5v00 | -0.5142841853499629
clock__skew__worst_setup__corner:min_tt_025C_5v00 | 0.4082415354651318
timing__hold__ws__corner:min_tt_025C_5v00 | 0.3654352479611031
timing__setup__ws__corner:min_tt_025C_5v00 | 68.14242873950049
timing__hold__tns__corner:min_tt_025C_5v00 | 0.0
timing__setup__tns__corner:min_tt_025C_5v00 | 0.0
timing__hold__wns__corner:min_tt_025C_5v00 | 0
timing__setup__wns__corner:min_tt_025C_5v00 | 0.0
timing__hold_vio__count__corner:min_tt_025C_5v00 | 0
timing__hold_r2r__ws__corner:min_tt_025C_5v00 | 0.365435
timing__hold_r2r_vio__count__corner:min_tt_025C_5v00 | 0
timing__setup_vio__count__corner:min_tt_025C_5v00 | 0
timing__setup_r2r__ws__corner:min_tt_025C_5v00 | 68.142426
timing__setup_r2r_vio__count__corner:min_tt_025C_5v00 | 0
timing__unannotated_net__count__corner:min_tt_025C_5v00 | 48
timing__unannotated_net_filtered__count__corner:min_tt_025C_5v00 | 0
design__max_slew_violation__count__corner:min_ss_125C_4v50 | 1198
design__max_fanout_violation__count__corner:min_ss_125C_4v50 | 49
design__max_cap_violation__count__corner:min_ss_125C_4v50 | 1
clock__skew__worst_hold__corner:min_ss_125C_4v50 | -0.7188463361362395
clock__skew__worst_setup__corner:min_ss_125C_4v50 | 0.5323511782075648
timing__hold__ws__corner:min_ss_125C_4v50 | 0.9191454524319935
timing__setup__ws__corner:min_ss_125C_4v50 | 41.299537403359246
timing__hold__tns__corner:min_ss_125C_4v50 | 0.0
timing__setup__tns__corner:min_ss_125C_4v50 | 0.0
timing__hold__wns__corner:min_ss_125C_4v50 | 0
timing__setup__wns__corner:min_ss_125C_4v50 | 0.0
timing__hold_vio__count__corner:min_ss_125C_4v50 | 0
timing__hold_r2r__ws__corner:min_ss_125C_4v50 | 0.919145
timing__hold_r2r_vio__count__corner:min_ss_125C_4v50 | 0
timing__setup_vio__count__corner:min_ss_125C_4v50 | 0
timing__setup_r2r__ws__corner:min_ss_125C_4v50 | 41.299538
timing__setup_r2r_vio__count__corner:min_ss_125C_4v50 | 0
timing__unannotated_net__count__corner:min_ss_125C_4v50 | 48
timing__unannotated_net_filtered__count__corner:min_ss_125C_4v50 | 0
design__max_slew_violation__count__corner:min_ff_n40C_5v50 | 0
design__max_fanout_violation__count__corner:min_ff_n40C_5v50 | 49
design__max_cap_violation__count__corner:min_ff_n40C_5v50 | 1
clock__skew__worst_hold__corner:min_ff_n40C_5v50 | -0.42337315407375814
clock__skew__worst_setup__corner:min_ff_n40C_5v50 | 0.35127737823933947
timing__hold__ws__corner:min_ff_n40C_5v50 | 0.12905943345983584
timing__setup__ws__corner:min_ff_n40C_5v50 | 75.70720087343469
timing__hold__tns__corner:min_ff_n40C_5v50 | 0.0
timing__setup__tns__corner:min_ff_n40C_5v50 | 0.0
timing__hold__wns__corner:min_ff_n40C_5v50 | 0
timing__setup__wns__corner:min_ff_n40C_5v50 | 0.0
timing__hold_vio__count__corner:min_ff_n40C_5v50 | 0
timing__hold_r2r__ws__corner:min_ff_n40C_5v50 | 0.129059
timing__hold_r2r_vio__count__corner:min_ff_n40C_5v50 | 0
timing__setup_vio__count__corner:min_ff_n40C_5v50 | 0
timing__setup_r2r__ws__corner:min_ff_n40C_5v50 | 80.027107
timing__setup_r2r_vio__count__corner:min_ff_n40C_5v50 | 0
timing__unannotated_net__count__corner:min_ff_n40C_5v50 | 48
timing__unannotated_net_filtered__count__corner:min_ff_n40C_5v50 | 0
design__max_slew_violation__count__corner:max_tt_025C_5v00 | 17
design__max_fanout_violation__count__corner:max_tt_025C_5v00 | 49
design__max_cap_violation__count__corner:max_tt_025C_5v00 | 2
clock__skew__worst_hold__corner:max_tt_025C_5v00 | -0.5452352057504225
clock__skew__worst_setup__corner:max_tt_025C_5v00 | 0.43804358602491184
timing__hold__ws__corner:max_tt_025C_5v00 | 0.38071102903355414
timing__setup__ws__corner:max_tt_025C_5v00 | 65.53607975131892
timing__hold__tns__corner:max_tt_025C_5v00 | 0.0
timing__setup__tns__corner:max_tt_025C_5v00 | 0.0
timing__hold__wns__corner:max_tt_025C_5v00 | 0
timing__setup__wns__corner:max_tt_025C_5v00 | 0.0
timing__hold_vio__count__corner:max_tt_025C_5v00 | 0
timing__hold_r2r__ws__corner:max_tt_025C_5v00 | 0.380711
timing__hold_r2r_vio__count__corner:max_tt_025C_5v00 | 0
timing__setup_vio__count__corner:max_tt_025C_5v00 | 0
timing__setup_r2r__ws__corner:max_tt_025C_5v00 | 65.536079
timing__setup_r2r_vio__count__corner:max_tt_025C_5v00 | 0
timing__unannotated_net__count__corner:max_tt_025C_5v00 | 48
timing__unannotated_net_filtered__count__corner:max_tt_025C_5v00 | 0
design__max_slew_violation__count__corner:max_ss_125C_4v50 | 2311
design__max_fanout_violation__count__corner:max_ss_125C_4v50 | 49
design__max_cap_violation__count__corner:max_ss_125C_4v50 | 3
clock__skew__worst_hold__corner:max_ss_125C_4v50 | -0.7784340059545704
clock__skew__worst_setup__corner:max_ss_125C_4v50 | 0.5864366935825444
timing__hold__ws__corner:max_ss_125C_4v50 | 0.9454461925399894
timing__setup__ws__corner:max_ss_125C_4v50 | 36.69131236025761
timing__hold__tns__corner:max_ss_125C_4v50 | 0.0
timing__setup__tns__corner:max_ss_125C_4v50 | 0.0
timing__hold__wns__corner:max_ss_125C_4v50 | 0
timing__setup__wns__corner:max_ss_125C_4v50 | 0.0
timing__hold_vio__count__corner:max_ss_125C_4v50 | 0
timing__hold_r2r__ws__corner:max_ss_125C_4v50 | 0.945446
timing__hold_r2r_vio__count__corner:max_ss_125C_4v50 | 0
timing__setup_vio__count__corner:max_ss_125C_4v50 | 0
timing__setup_r2r__ws__corner:max_ss_125C_4v50 | 36.691311
timing__setup_r2r_vio__count__corner:max_ss_125C_4v50 | 0
timing__unannotated_net__count__corner:max_ss_125C_4v50 | 48
timing__unannotated_net_filtered__count__corner:max_ss_125C_4v50 | 0
design__max_slew_violation__count__corner:max_ff_n40C_5v50 | 0
design__max_fanout_violation__count__corner:max_ff_n40C_5v50 | 49
design__max_cap_violation__count__corner:max_ff_n40C_5v50 | 2
clock__skew__worst_hold__corner:max_ff_n40C_5v50 | -0.44139651516525835
clock__skew__worst_setup__corner:max_ff_n40C_5v50 | 0.3697353361461205
timing__hold__ws__corner:max_ff_n40C_5v50 | 0.139754767270047
timing__setup__ws__corner:max_ff_n40C_5v50 | 75.56431783065968
timing__hold__tns__corner:max_ff_n40C_5v50 | 0.0
timing__setup__tns__corner:max_ff_n40C_5v50 | 0.0
timing__hold__wns__corner:max_ff_n40C_5v50 | 0
timing__setup__wns__corner:max_ff_n40C_5v50 | 0.0
timing__hold_vio__count__corner:max_ff_n40C_5v50 | 0
timing__hold_r2r__ws__corner:max_ff_n40C_5v50 | 0.139755
timing__hold_r2r_vio__count__corner:max_ff_n40C_5v50 | 0
timing__setup_vio__count__corner:max_ff_n40C_5v50 | 0
timing__setup_r2r__ws__corner:max_ff_n40C_5v50 | 78.330833
timing__setup_r2r_vio__count__corner:max_ff_n40C_5v50 | 0
timing__unannotated_net__count__corner:max_ff_n40C_5v50 | 48
timing__unannotated_net_filtered__count__corner:max_ff_n40C_5v50 | 0
timing__unannotated_net__count | 48
timing__unannotated_net_filtered__count | 0
design_powergrid__voltage__worst__net:VDD__corner:nom_tt_025C_5v00 | 4.99886
design_powergrid__drop__average__net:VDD__corner:nom_tt_025C_5v00 | 4.99977
design_powergrid__drop__worst__net:VDD__corner:nom_tt_025C_5v00 | 0.00114061
design_powergrid__voltage__worst__net:VSS__corner:nom_tt_025C_5v00 | 0.000788369
design_powergrid__drop__average__net:VSS__corner:nom_tt_025C_5v00 | 0.000218475
design_powergrid__drop__worst__net:VSS__corner:nom_tt_025C_5v00 | 0.000788369
design_powergrid__voltage__worst | 0.000788369
design_powergrid__voltage__worst__net:VDD | 4.99886
design_powergrid__drop__worst | 0.00114061
design_powergrid__drop__worst__net:VDD | 0.00114061
design_powergrid__voltage__worst__net:VSS | 0.000788369
design_powergrid__drop__worst__net:VSS | 0.000788369
ir__voltage__worst | 5
ir__drop__avg | 0.0002339999999999999957638052716646370754460804164409637451171875
ir__drop__worst | 0.0011399999999999999543420781122904372750781476497650146484375
design__xor_difference__count | 0
magic__drc_error__count | 0
magic__illegal_overlap__count | 0
design__lvs_device_difference__count | 0
design__lvs_net_difference__count | 0
design__lvs_property_fail__count | 0
design__lvs_error__count | 0
design__lvs_unmatched_device__count | 0
design__lvs_unmatched_net__count | 0
design__lvs_unmatched_pin__count | 0
