SantiagoArenas2/Arqui_proyecto3/asic/resultados/ff/layout.png

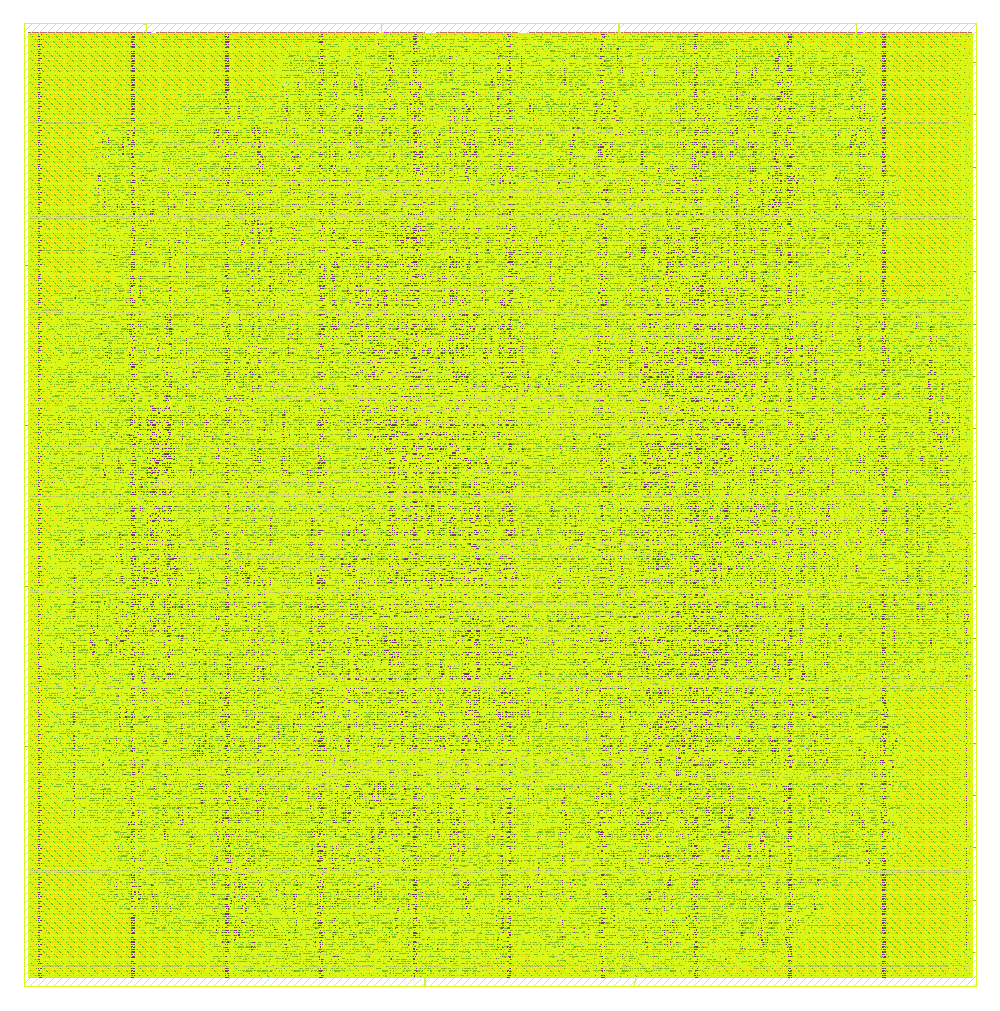
asic/resultados/ff/layout.png
