SantiagoArenas2/Arqui_proyecto3/asic/resultados/final/layout.png

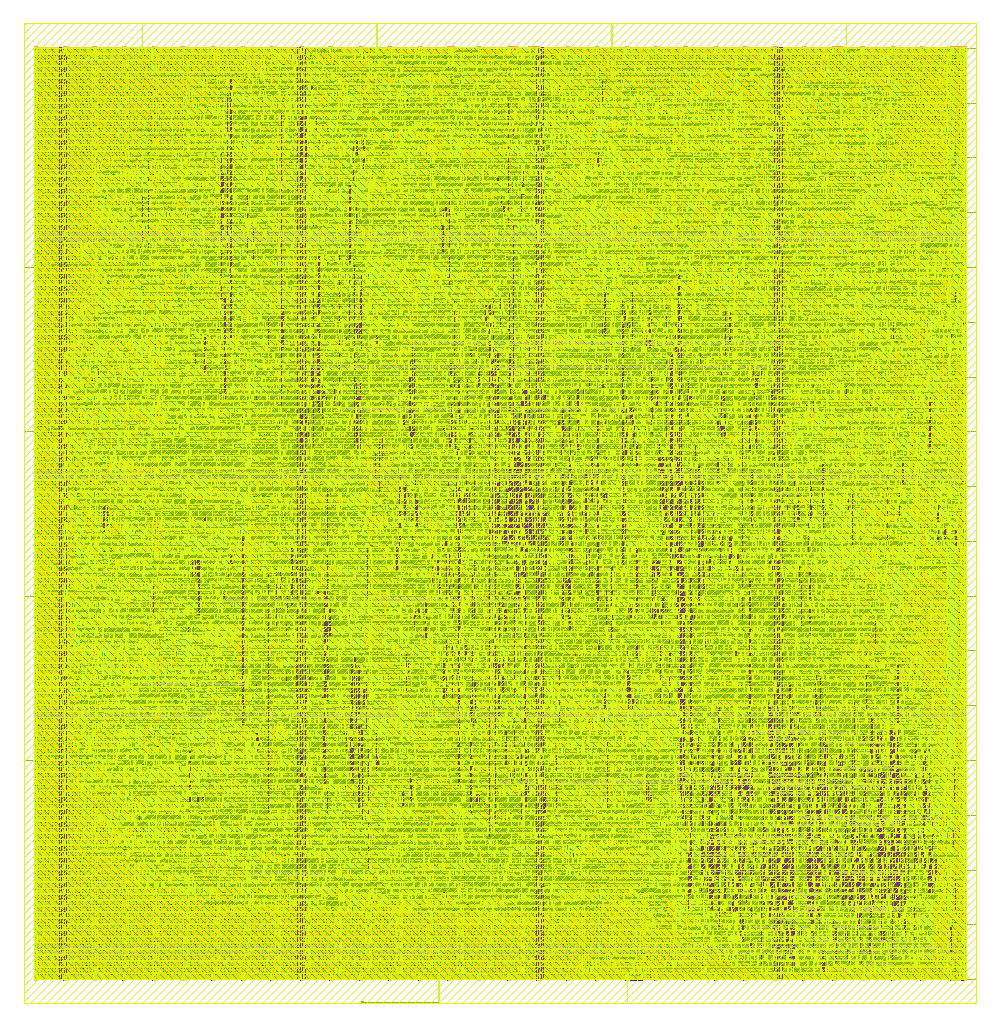
asic/resultados/final/layout.png
