SantiagoArenas2/Arqui_proyecto3/asic/resultados/predecodificado/layout.png

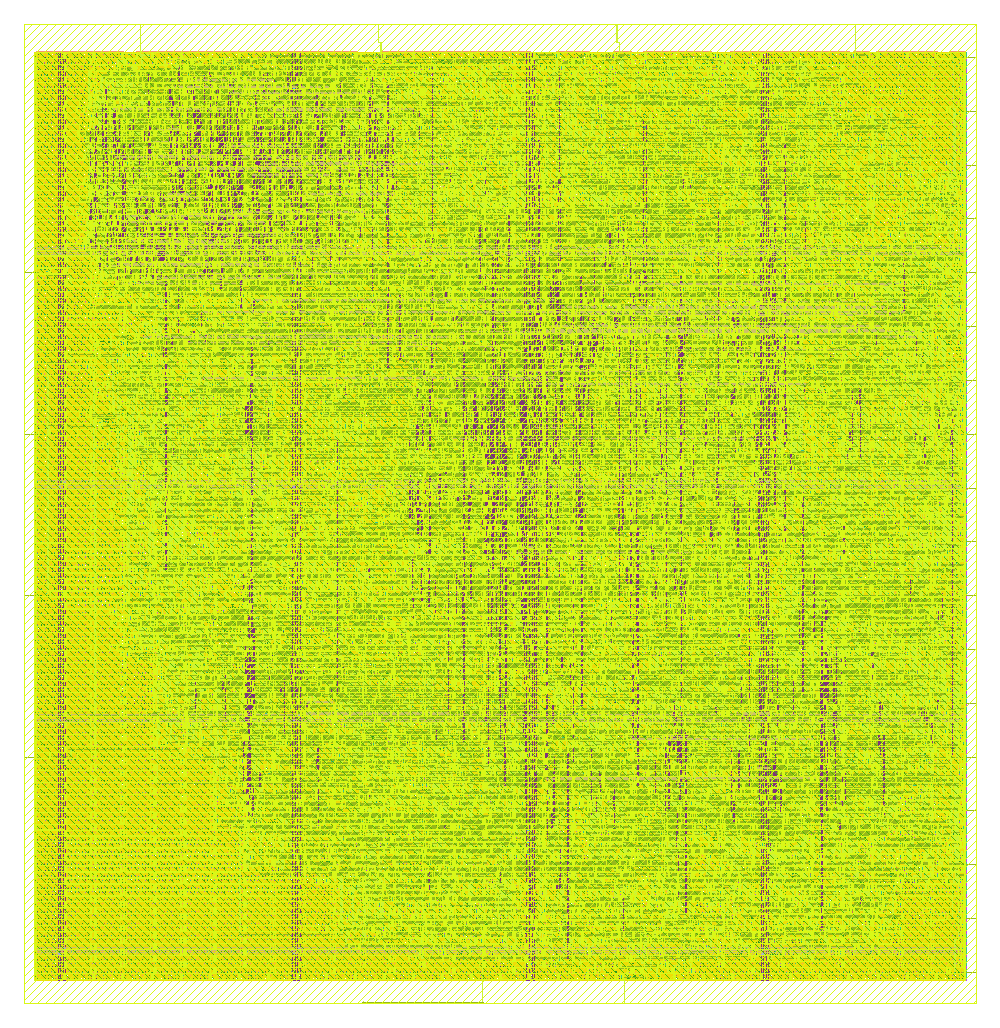
asic/resultados/predecodificado/layout.png
