SantiagoArenas2/Arqui_proyecto3/asic/resultados/util_55/layout.png

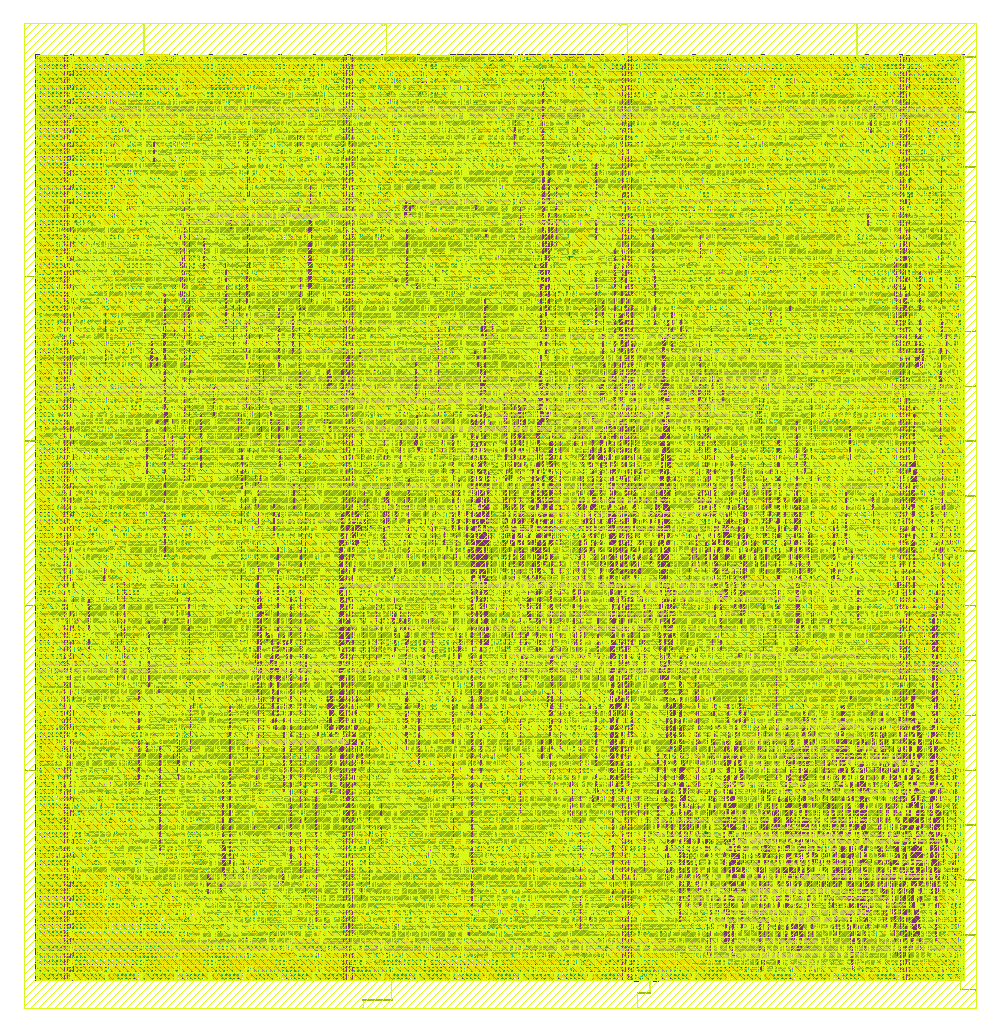
asic/resultados/util_55/layout.png
