SantiagoArenas2/Arqui_proyecto3/asic/resultados/util_70/layout.png

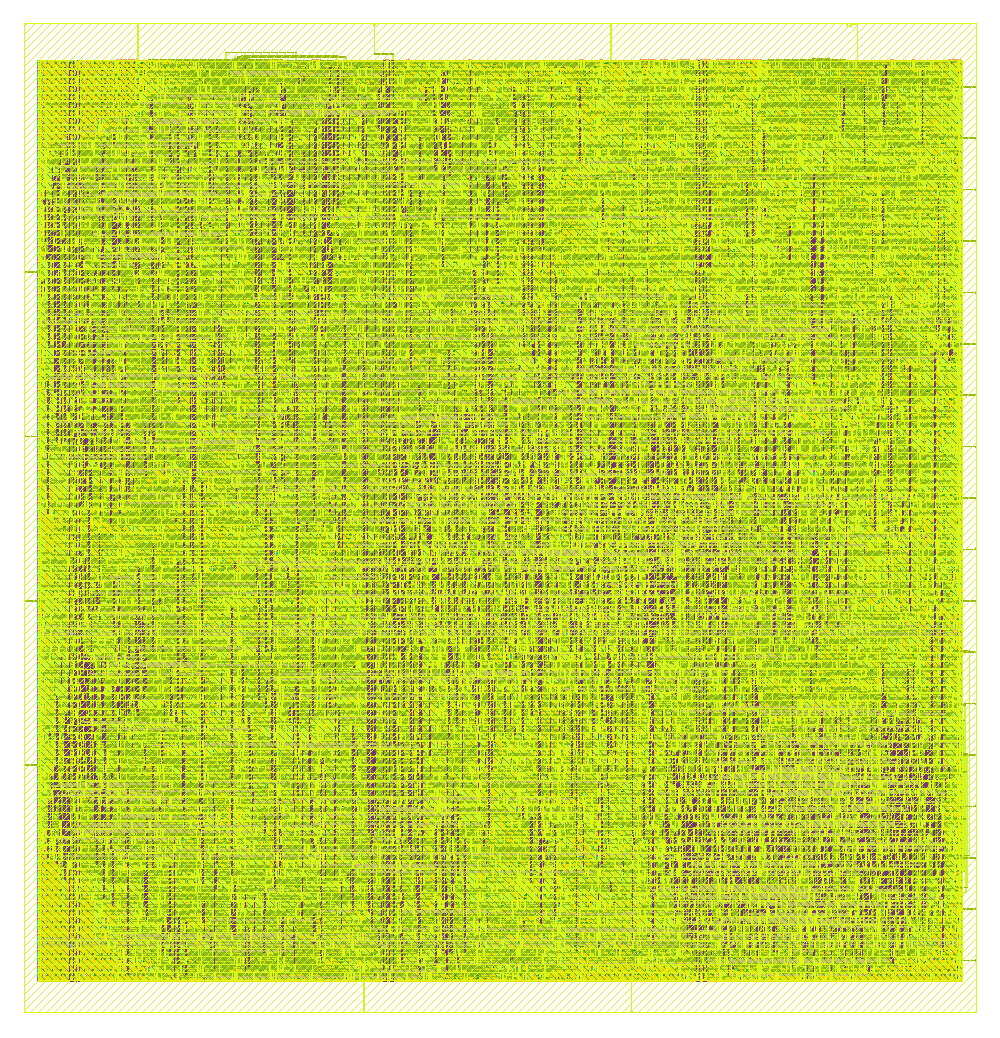
asic/resultados/util_70/layout.png
